wntrblm/Speak_to_Me/README.md

# Winterbloom Speak to Me

Speak to Me is a high quality headphone amplifier and low quality speaker monitor for Eurorack.

More details available at https://winterbloom.com/store/speak-to-me

## Repository layout

This repository contains the hardware design files and user guide for Speak to Me:

- **hardware/** contains the hardware design files for the mainboard, headphone jack breakout, and blank panel. These are all created using KiCAD.
- **user_guide/** contains the user's guide source files. These are written in Markdown and published using MkDocs.

## License and contributing

Speak to Me is open-source hardware and software, however, licensing a project like this is a little complicated. Please take a chance to review the [LICENSE](LICENSE.md) file.

We welcome contributions! Please read our [Code of Conduct](CODE_OF_CONDUCT.md) first.
