wntrblm/Speak_to_Me/hardware/headphone-breakout/3dmodels/CUI_DEVICES_SJ-63083D.step

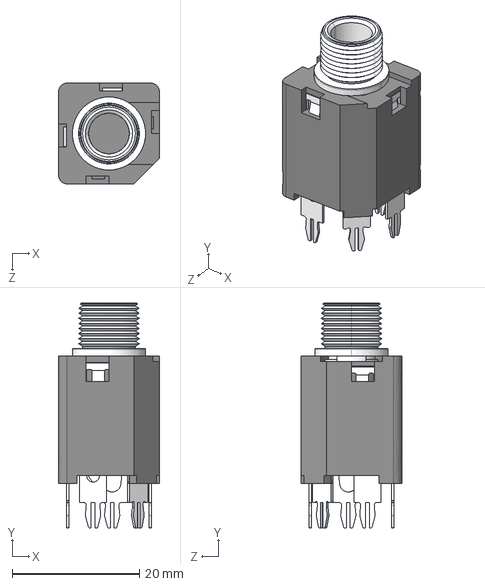
[picture p1: CAD file, 2021-05-23]
hardware/headphone-breakout/3dmodels/CUI_DEVICES_SJ-63083D.step
15.8 x 35.3 x 15.8 mm
