wntrblm/Speak_to_Me/hardware/board/3dmodels/AS04008PS-4W-WR-R.step

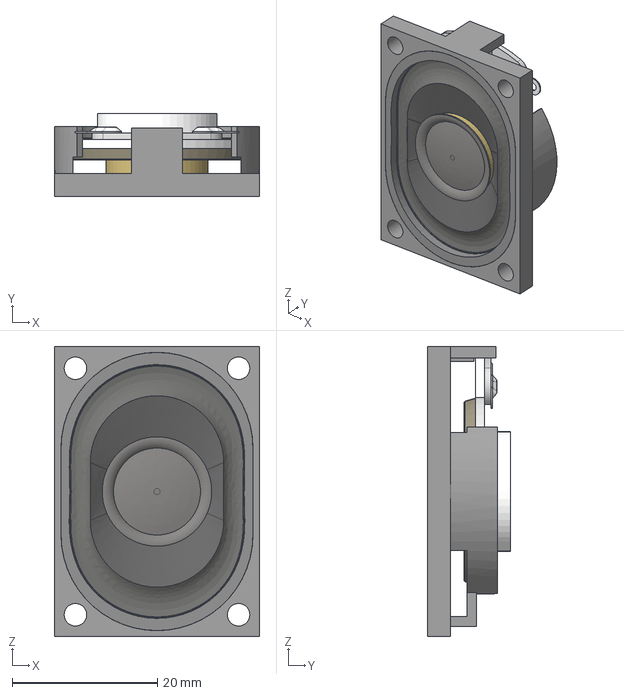
[picture p2: CAD file, 2021-05-23]
hardware/board/3dmodels/AS04008PS-4W-WR-R.step
28.3 x 11.5 x 40.0 mm
