wntrblm/Speak_to_Me/user_guide/docs/build.md

---
title: Kit build guide
---

# Build

Welcome to the build guide for Speak to Me's DIY kit. We hope you have a great time putting this module together and a wonderful time using it.

Please **read all instructions** thoroughly before starting. If you have questions or run into trouble please reach out to us on [discord] or drop us an email at support@winterbloom.com.

This kit is a beginner-level kit, but it does have a few tricky parts. If it's your first time soldering we recommend reading through [Adafruit's guide to excellent soldering](https://learn.adafruit.com/adafruit-guide-excellent-soldering) and practicing a little before jumping in.

This build takes around **two hours** to complete.

[discord]: https://discord.gg/UpfqghQ

## Tools required

Before you begin, make sure that you've got:

-   Safety glasses. Yes, **really**. A pair like [these][safety glasses] are fine.
-   Proper ventilation, like this [small filtered fan](https://a.co/d/eUfPCRO).
-   A **temperature-controlled** soldering iron, like this [Hakko] or the [Pinecil]. It is very important to use a temperature-controlled iron, since unregulated irons can easily get hot enough to damage components. You should set your iron temperature based on your solder manufacturer's recommendations.
-   Solder. We recommend [Adafruit's SAC305 solder][adafruit solder] or [Kester 275 K100LD].

!!! question "Flux"
    We suggest using solder with "no clean" flux. If you use a different kind of flux, be sure to carefully clean the flux residue off based on the guidelines provided by the manufacturer of your solder. Take special care with the LEDs and potentiometers, as they can be damaged by water and flux cleaners.

[safety glasses]: https://a.co/d/dMXvPP6
[tweezers]: https://www.adafruit.com/product/422
[Hakko]: https://www.adafruit.com/product/1204
[Pinecil]: https://pine64.com/product/pinecil-smart-mini-portable-soldering-iron/
[adafruit solder]: https://www.adafruit.com/product/734
[Kester 275 K100LD]: https://www.kester.com/products/product/275-flux-cored-wire
[flux pen]: https://www.sra-solder.com/sra-312-no-clean-flux-pen-refillable

## Kit contents

Your kit should contain the following items. If any are missing please email us at support@winterbloom.com.

<winter-image-map src="../images/kit.svg">
    <winter-image-map-item id="mainboard">Mainboard</winter-image-map-item>
    <winter-image-map-item id="panel">Front panel</winter-image-map-item>
    <winter-image-map-item id="jacks">1/8" jacks (2)</winter-image-map-item>
    <winter-image-map-item id="jack-nuts">Hex nuts for the 1/8" jacks (2)</winter-image-map-item>
    <winter-image-map-item id="power-header">Eurorack power header</winter-image-map-item>
    <winter-image-map-item id="rubber-band">Rubber band</winter-image-map-item>
    <winter-image-map-item id="jst-cable">JST wiring harness</winter-image-map-item>
    <winter-image-map-item id="_2p5-l-wrench">2.5mm L wrench</winter-image-map-item>
    <winter-image-map-item id="_2-l-wrench">2mm L wrench</winter-image-map-item>
    <winter-image-map-item id="m3-bolts">M3x12 black hex bolts (4)</winter-image-map-item>
    <winter-image-map-item id="m3-nuts">M3 nuts (4)</winter-image-map-item>
    <winter-image-map-item id="jst-header">JST XH-2 header</winter-image-map-item>
    <winter-image-map-item id="pot">Stereo potentiometer</winter-image-map-item>
    <winter-image-map-item id="ffc">Flat flex cable</winter-image-map-item>
    <winter-image-map-item id="speaker">Speaker</winter-image-map-item>
    <winter-image-map-item id="grill">Grille cloth</winter-image-map-item>
    <winter-image-map-item id="big-jack">1/4 stereo jack</winter-image-map-item>
    <winter-image-map-item id="spacer">Speaker spacer</winter-image-map-item>
    <winter-image-map-item id="knob">Knob</winter-image-map-item>
    <winter-image-map-item id="headphone-breakout">Headphone jack breakout board</winter-image-map-item>
</winter-image-map>

- (1) Mainboard
- (1) Front panel
- (1) Headphone jack breakout board
- (1) Stereo potentiometer, including nut & washer
- (1) Speaker
- (1) 20mm aluminum knob
- (4) M3x12 black hex bolts
- (4) M3 nuts
- (1) Grille cloth
- (1) Speaker spacer
- (1) 2mm L wrench
- (1) 2.5mm L wrench
- (1) 5-position flat flex cable
- (2) 1/8" jacks, including nuts
- (1) 1/4" stereo jack, including nut
- (1) JST XH-2 header
- (1) JST 2-pin wiring harness
- (1) Eurorack power header
- (1) Rubber band

## Soldering the power header

Your first task is to place and solder the power header and JST header to the mainboard.

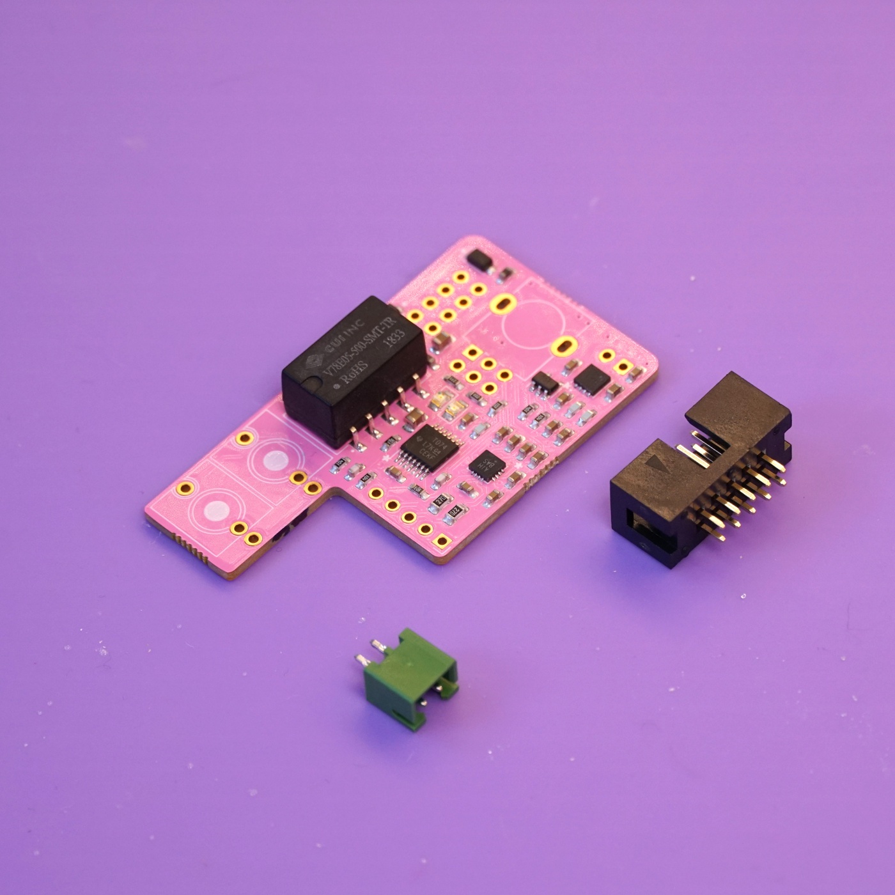
[picture p3: user_guide/docs/images/2-mb-3.jpg]
The mainboard, power header, and JST header


Start by placing the power header onto the back side of the mainboard, being careful to align the notch in the header with the drawing on the board. The power header fits snugly, so you might have to give it a little pressure to push it all the way in.

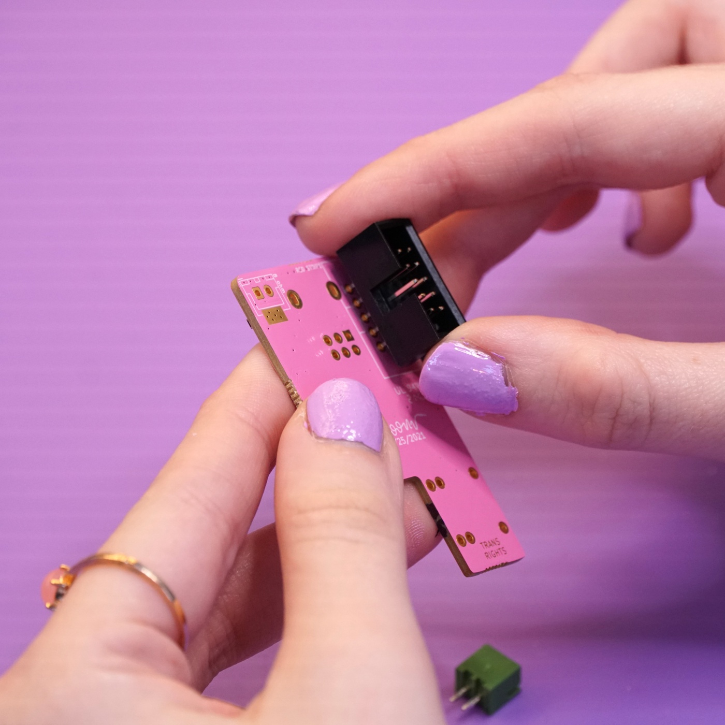
[picture p4: user_guide/docs/images/3-pw-5.jpg]
The power header being placed on to the back side of the motherboard


Flip the board over to the front side and solder the header's 10 pins. Take care not to damage any of the nearby components.

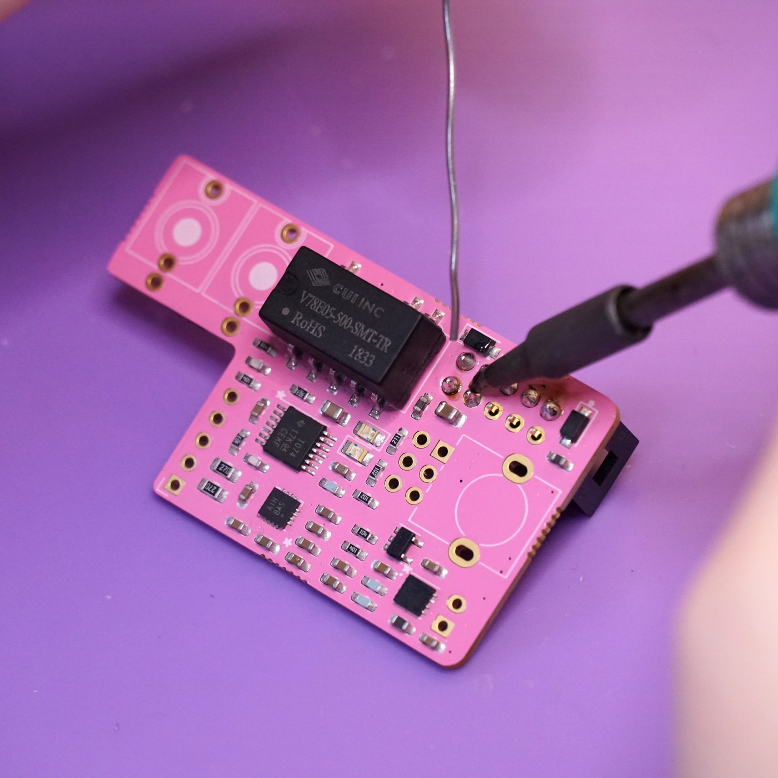
[picture p5: user_guide/docs/images/4-pws-8.jpg]
The power header's pins being soldered in place


Next, place the JST header on the back side of the board. Just like with the power header, align the header with the drawing on the board. The header should not hang over the edge of the board.

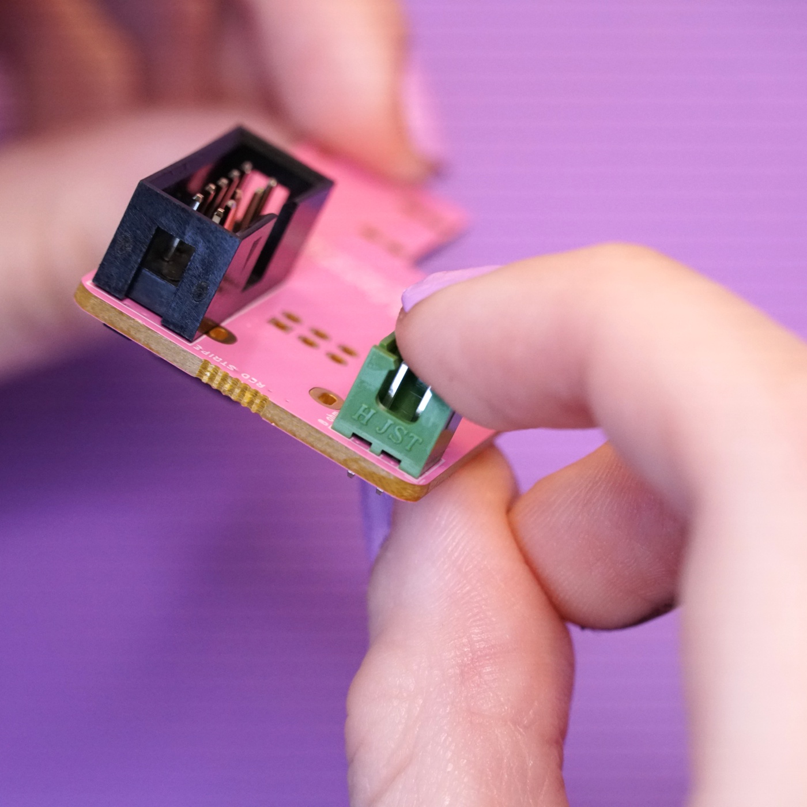
[picture p6: user_guide/docs/images/5-jst-4.jpg]
The JST header placed on the back side of the board


Flip the board over and solder the JST header's two pins.

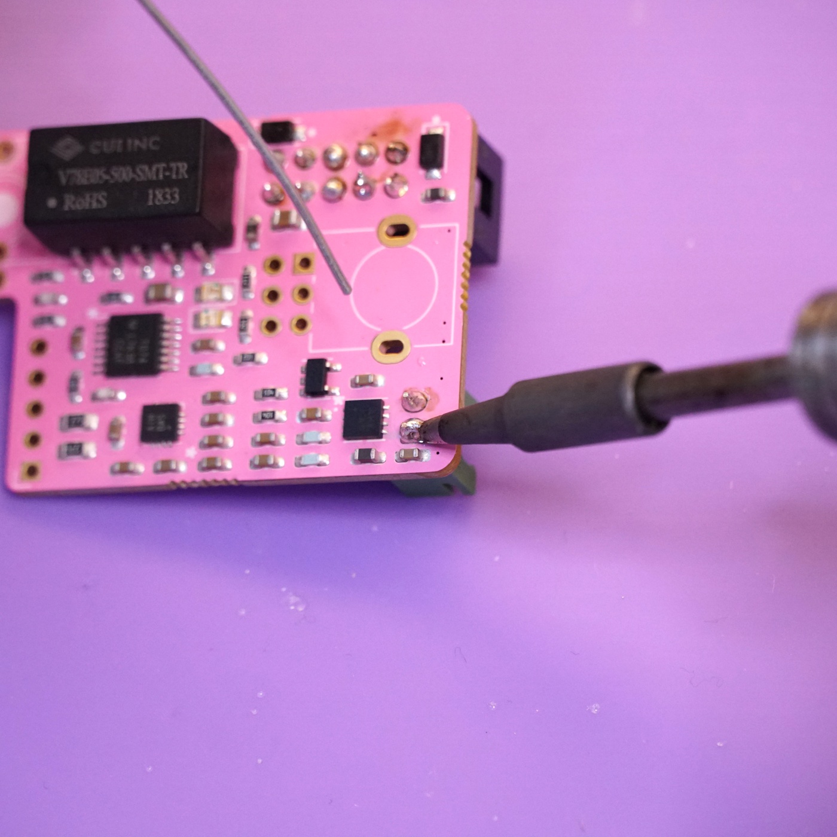
[picture p7: user_guide/docs/images/6-jsts-3.jpg]
The JST header's pin being soldered in place


## Placing the front side components

Next up is placing the components on the front side of the mainboard. You'll need the 1/8" jacks, the stereo potentiometer, the front panel, and the rubber band for this section.

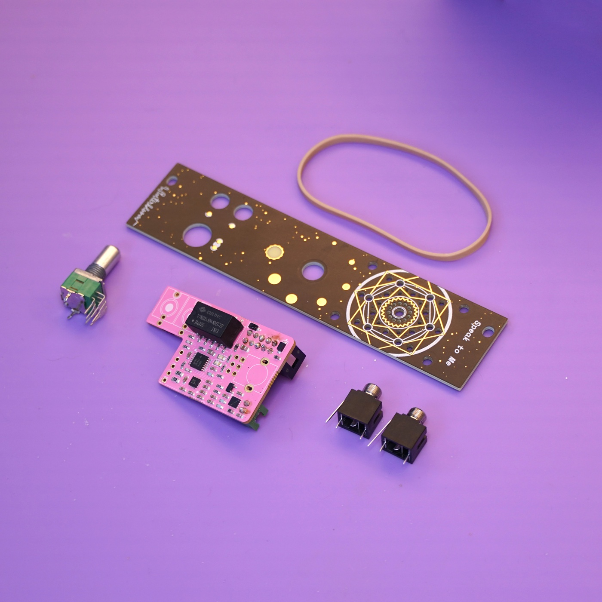
[picture p8: user_guide/docs/images/7-jacks-and-pot-4.jpg]
The panel, mainboard, 1/8" jacks, stereo potentiometer, and a rubber band


Start by placing the potentiometer on the front side of the board. You might need to slightly straighten out the legs of the potentiometer to get it to go in - don't use excessive force to push it in. Remove the nut and washer on the potentiometer and set it aside for now.

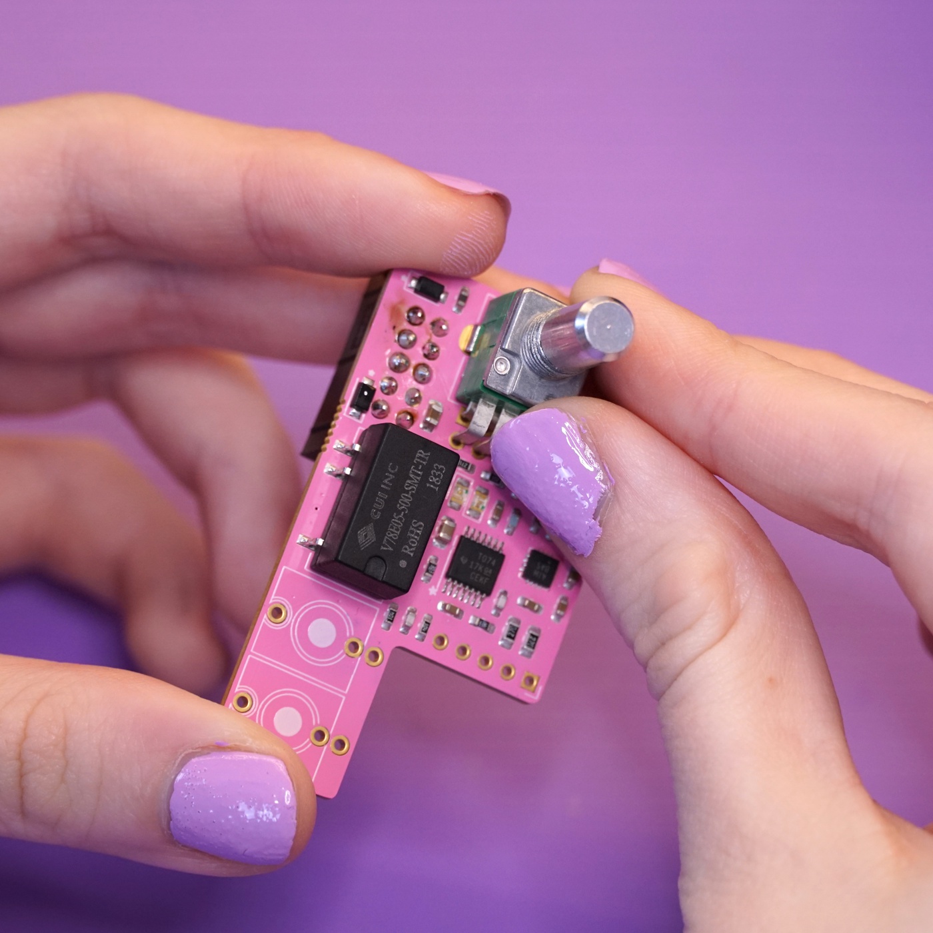
[picture p9: user_guide/docs/images/8-pot-3.jpg]
The potentiometer placed on the front side of the board


Continue by placing the two 1/8" jacks on the front side of the board. Be sure to get the little flexible third leg into its hole.

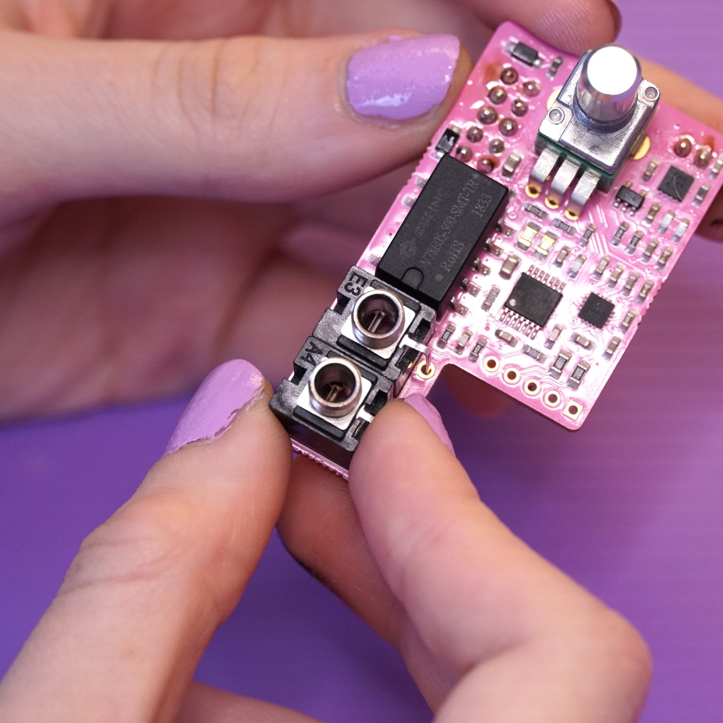
[picture p10: user_guide/docs/images/9-jacks-2.jpg]
The two 1/8" jacks placed on the front side of the board


## Using the front panel as a jig

Since the potentiometer and jacks need to peek through the front panel, you can use it as a jig to make sure everything stays in the right place while soldering. Carefully line up the front panel's holes with the potentiometer and jack and push the front panel on.

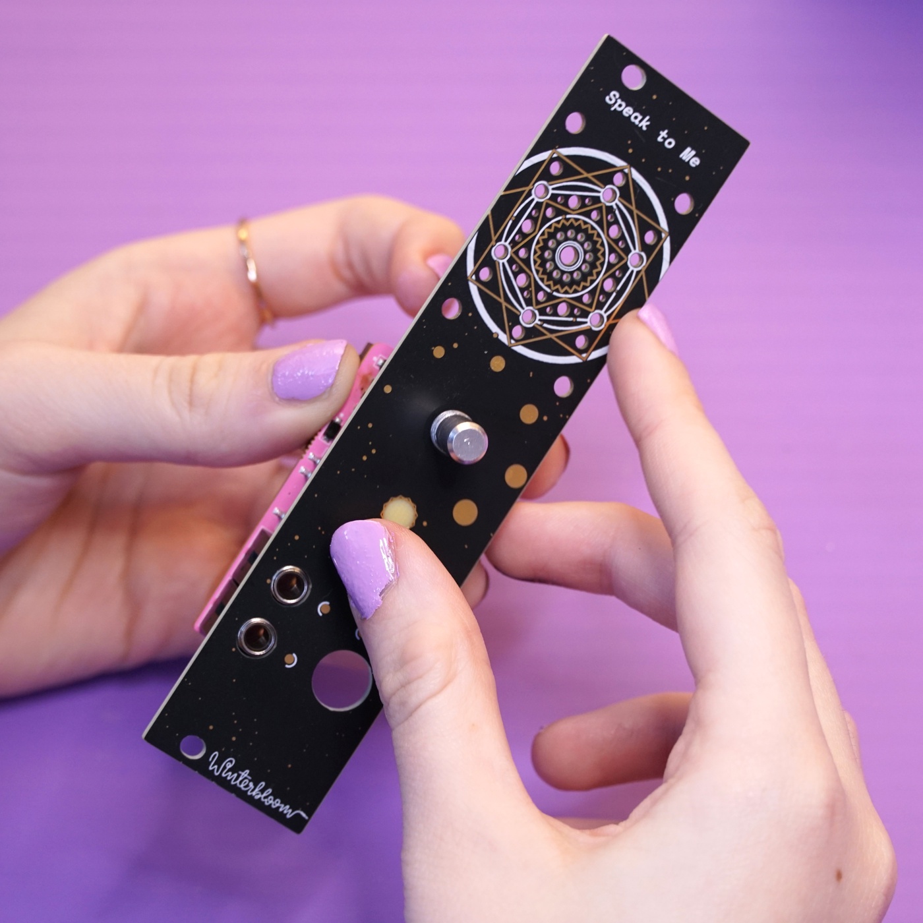
[picture p11: user_guide/docs/images/10-panel-1.jpg]
The panel being placed over the mainboard's jacks and potentiometer


Use the rubber band to temporarily hold the front panel on while you're working on it. You'll need to double- or triple- over the rubber band to get it tight.

<winter-carousel>
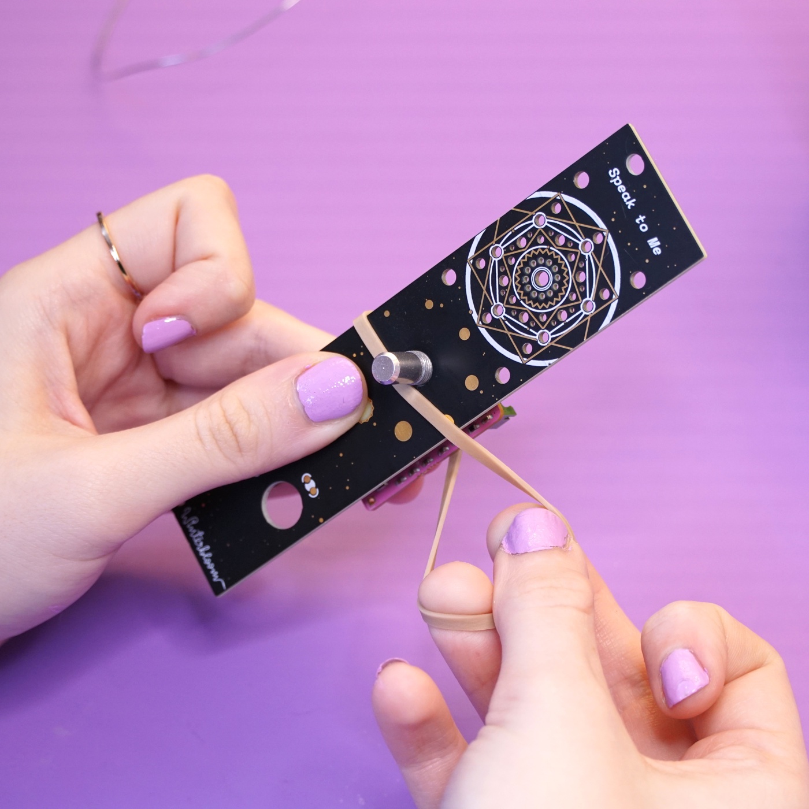
[picture p12: user_guide/docs/images/11-rubber-band-4.jpg]
A rubber band being pulled taught across the center of the module
    
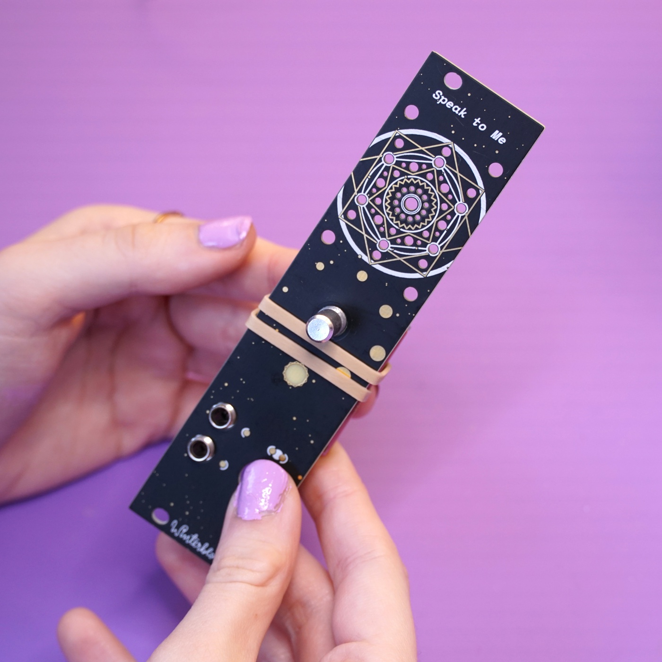
[picture p13: user_guide/docs/images/11-rubber-band-3.jpg]
The module with a doubled-overed rubber band holding the panel in place
    
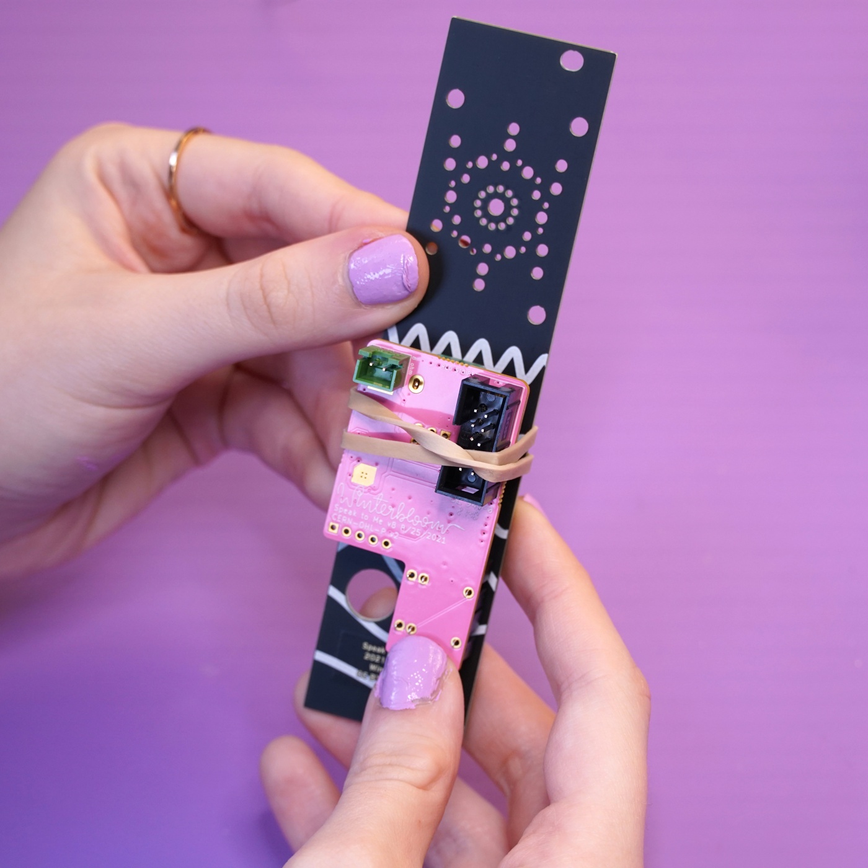
[picture p14: user_guide/docs/images/11-rubber-band-2.jpg]
The same but showing the back side of the module
    
</winter-carousel>

## Soldering the front side components

With everything held in place, you can now flip the module over and solder all of the front panel components in place. As you go, take a moment now and then to check that everything is flush with the panel and mainboard.

Start by soldering the two 1/8" jacks.

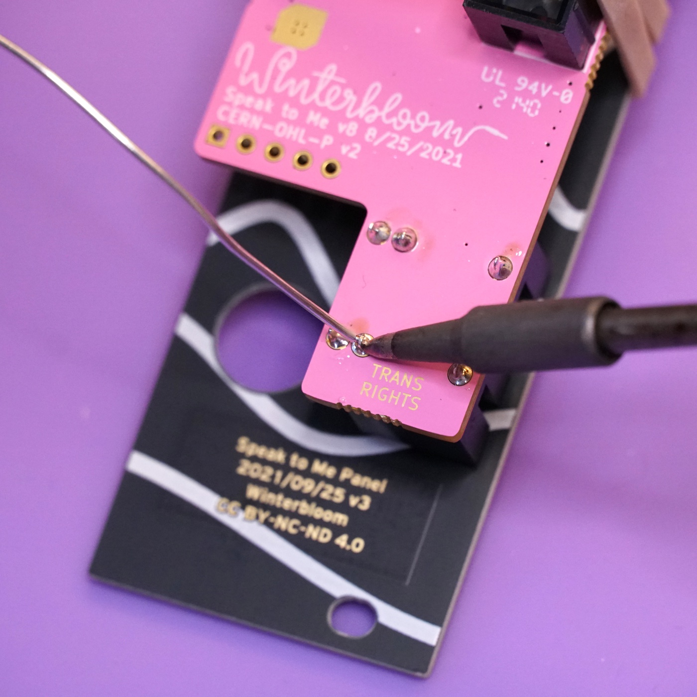
[picture p15: user_guide/docs/images/12-soldering-jacks-2.jpg]
The pins on the 1/8" jacks being soldered in place


Next up is the potentiometer. This one can be a little tricky so read through all of these instructions and use caution. First, move the rubber band slightly to get a clear look at the potentiometer's holes.

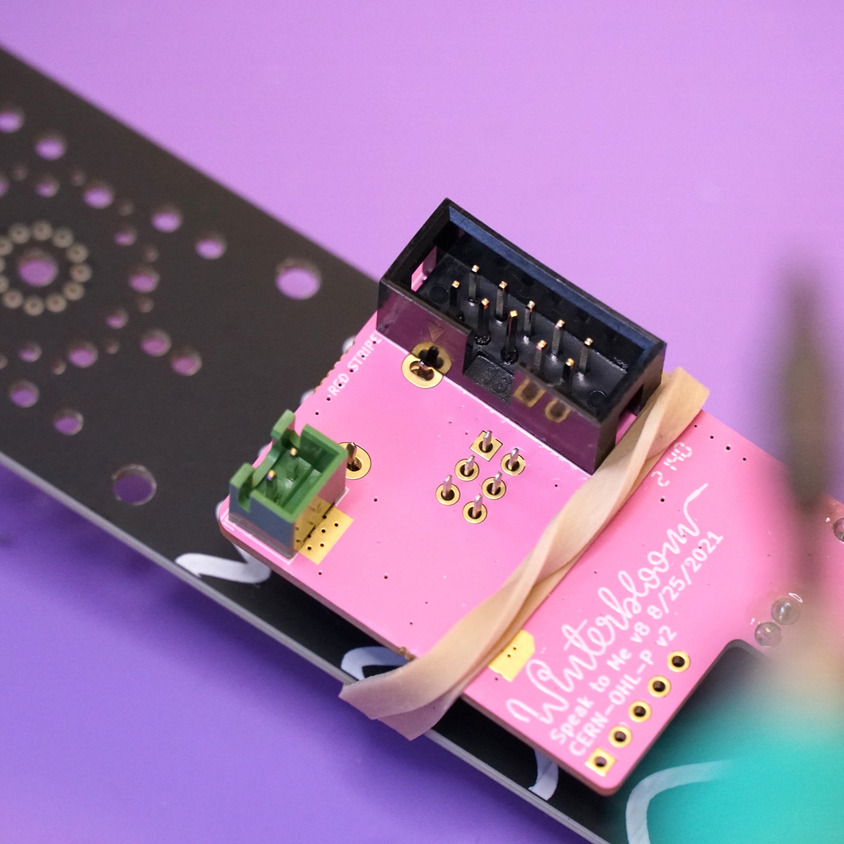
[picture p16: user_guide/docs/images/13-soldering-pot-9.jpg]
The back side of the board, showing the rubber band moved down slightly to reveal the pins and legs for the potentiometer


Next, solder the two *large* legs of the potentiometer one at a time. When soldering the one next to the power header, be careful not to melt the power header with your iron. After soldering the first one, double-check that the potentiometer is flush with the mainboard and adjust if needed.

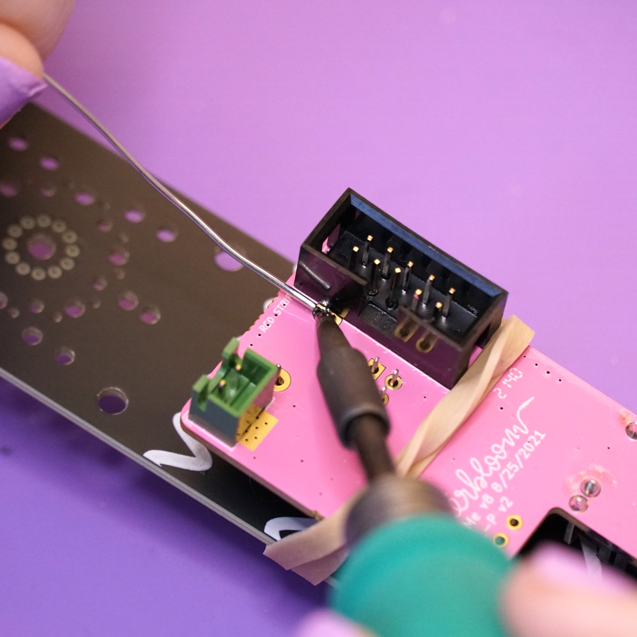
[picture p17: user_guide/docs/images/13-soldering-pot-2.jpg]
The potentiometer's leg being soldered in place


With the two legs soldered, finish up by soldering the six remaining pins.

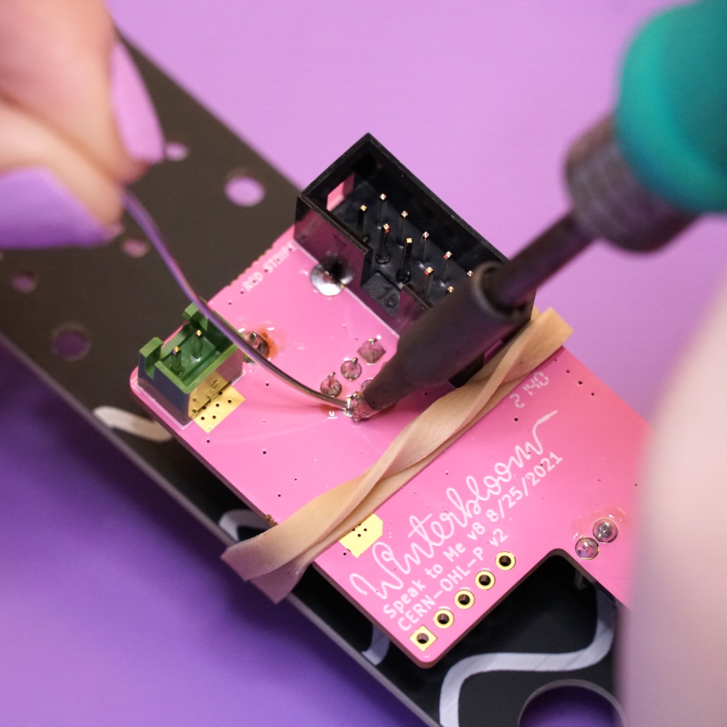
[picture p18: user_guide/docs/images/14-soldering-pot-pt-2-2.jpg]
The potentiometer's 6 pins being soldered


## Soldering the flat flex cable to the mainboard

Next up is soldering the flat flex cable to the mainboard.

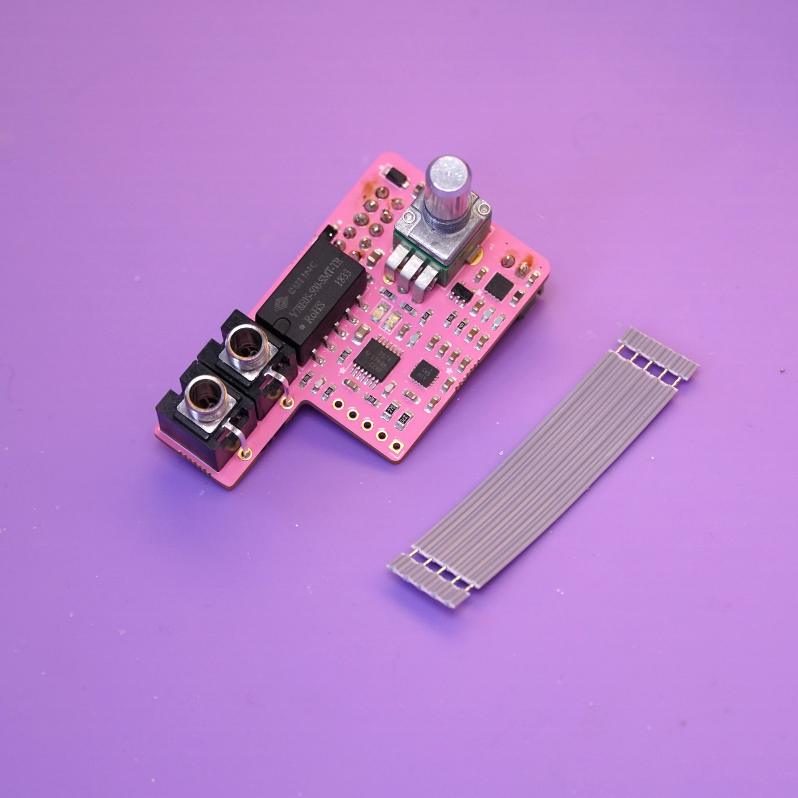
[picture p19: user_guide/docs/images/15-ffc-1.jpg]
The mainboard and the flat flex cable


Prepare the flat flex cable by removing the cover on one side of it. Just pull up lightly to get the cover to come off- **do not cut the flat flex cable**.

<winter-carousel>
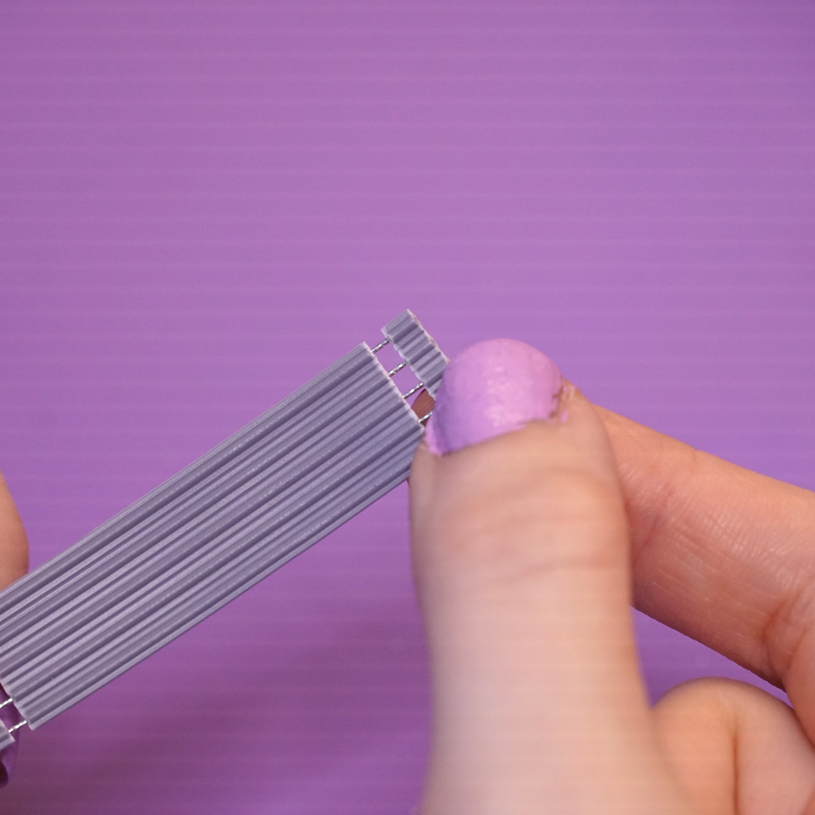
[picture p20: user_guide/docs/images/16-ffc-prep-3.jpg]
The flat flex cable with the small cover on the top of it being held lightly
    
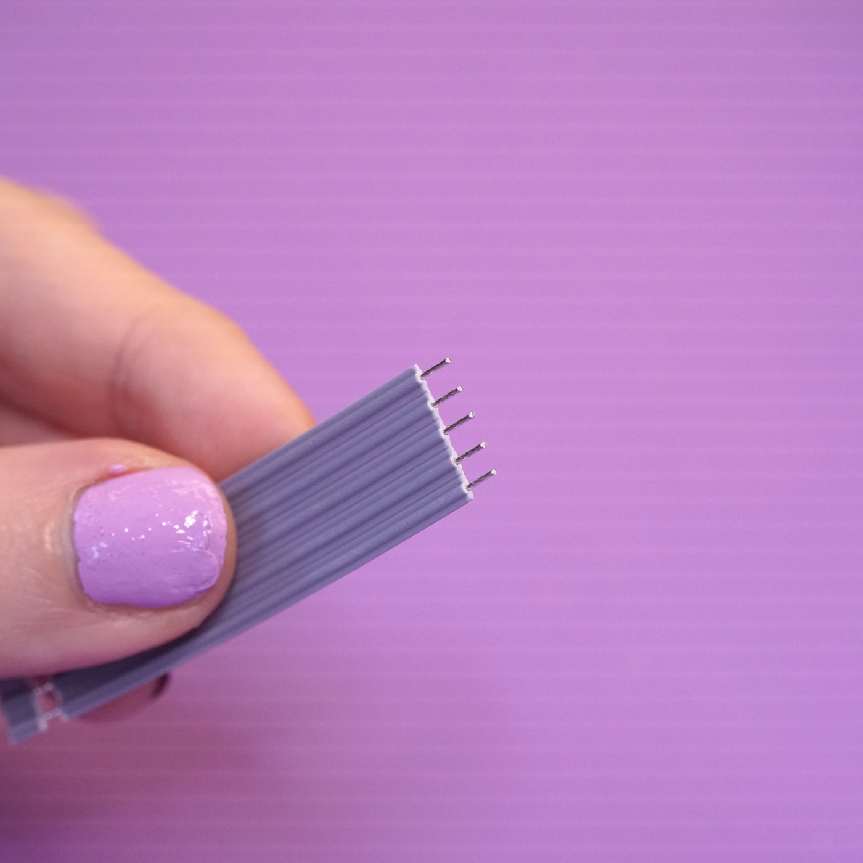
[picture p21: user_guide/docs/images/16-ffc-prep-1.jpg]
The flat flex cable with the small cover on the top removed, revealing the conductors
    
</winter-carousel>

Push the exposed conductors of the flat flex cable through the matching holes on the motherboard. This is designed to go together easily, just be take care not to bend any of the conductors.

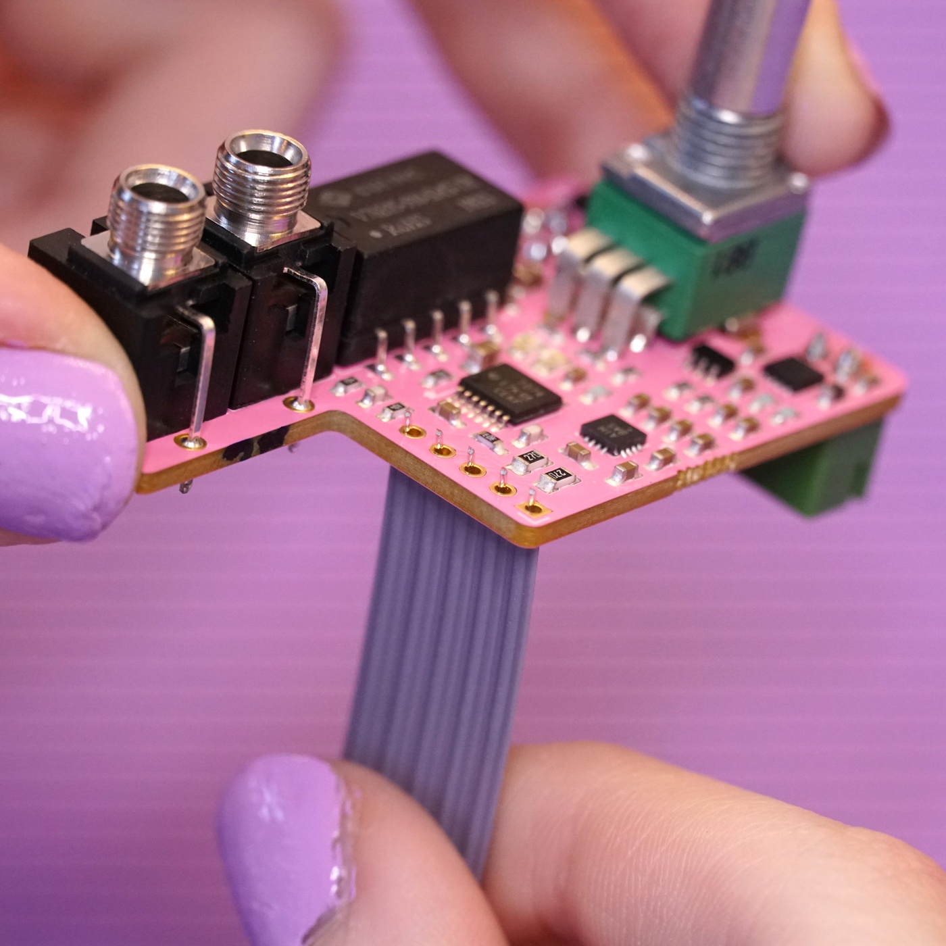
[picture p22: user_guide/docs/images/17-ffc-connect-3.jpg]
The flat flex cable placed through the five holes on the mainboard through the back side


With everything in place, solder the five flat flex cable conductors to the motherboard.

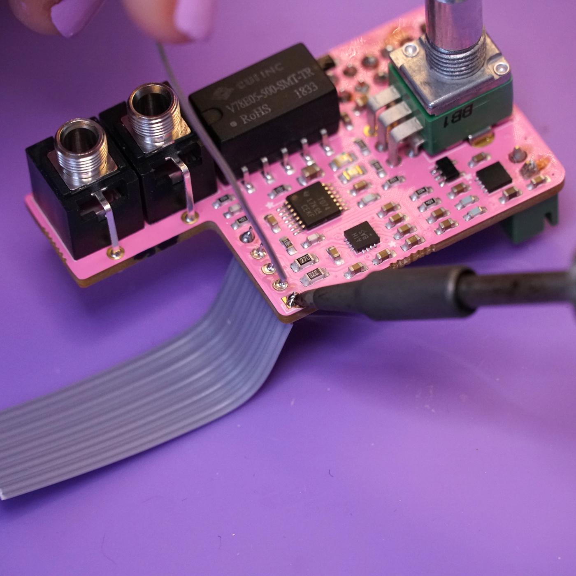
[picture p23: user_guide/docs/images/18-solder-ffc-1.jpg]
The flat flex cable's five conductors soldered onto the mainboard


## Soldering the flat flex cable to the headphone breakout

With one side of the flat flex cable done, the next step is to connect the other side to the headphone breakout board.

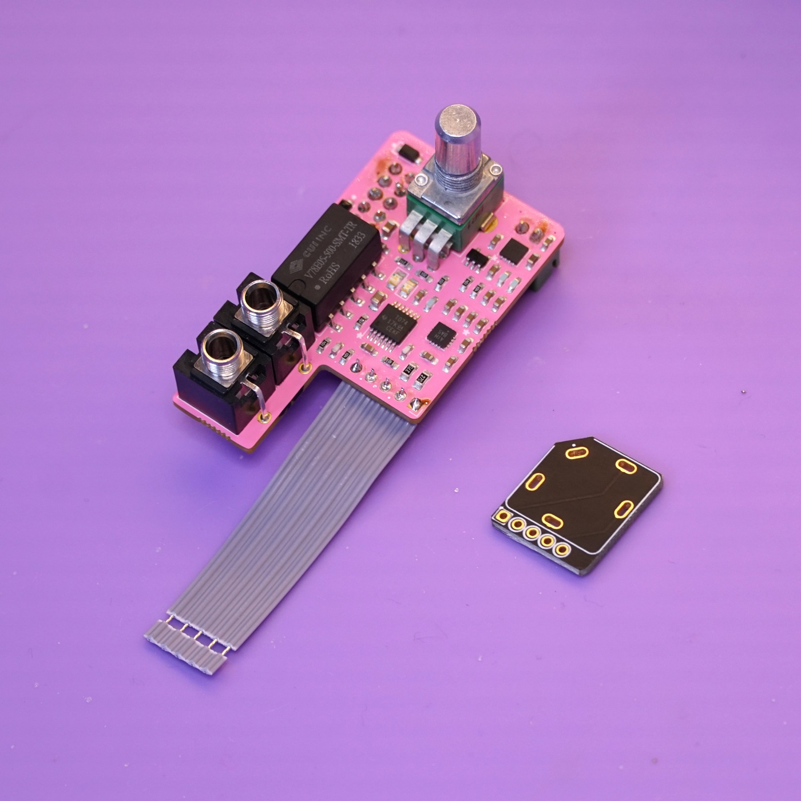
[picture p24: user_guide/docs/images/19-ffc-and-hp-breakout-5.jpg]
The mainboard (with the flat flex cable attached) and the headphone breakout board


Just like in the previous step, remove the cover for the flat flex cable. Push it through the matching holes on the headphone breakout board. Note the orientation of the breakout board relative to the mainboard. The side **without any text** is the front side and should be facing the same direction as the front side of the mainboard.

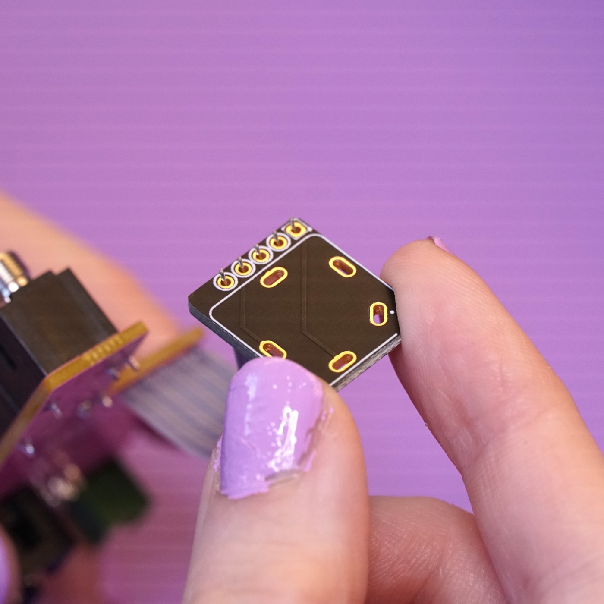
[picture p25: user_guide/docs/images/20-ffc-hp-1.jpg]
The five conductors of the flat flex cable pushed through the five holes on the headphone breakout board


Double check the orientation and then solder the flat flex cable in place.

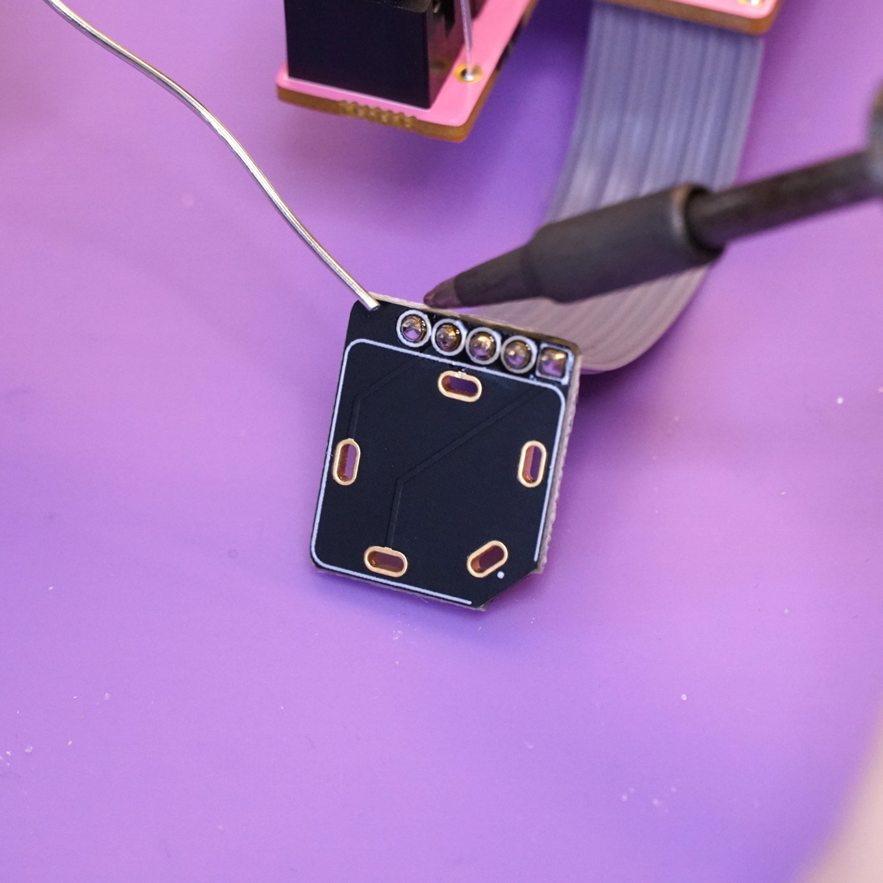
[picture p26: user_guide/docs/images/21-ffc-soldering4.jpg]
The five conductors of the flat flex cable soldered to the headphone breakout board


## Soldering the 1/4" jack

Next up is soldering the large 1/4" jack to the jack breakout board. Before starting, remove the nut and washer from the jack and set aside.

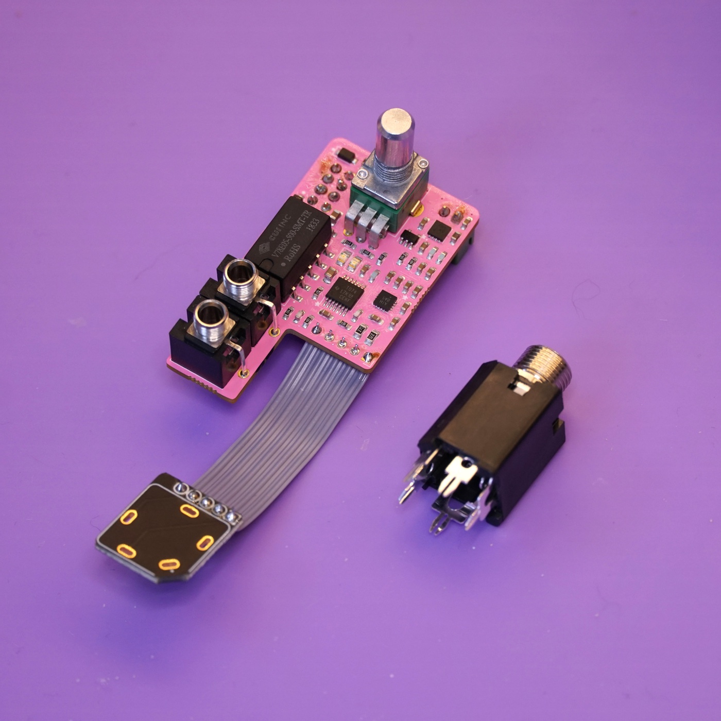
[picture p27: user_guide/docs/images/22-big-jack-4.jpg]
The mainboard assembly with flat flex cable and headphone breakout attached along with the large 1/4" jack


Place the jack on the front side of the breakout board. The jack has one slanted side so that it can only go in one way. The jack's legs will not go all the way through the board so don't use excessive force to place it.

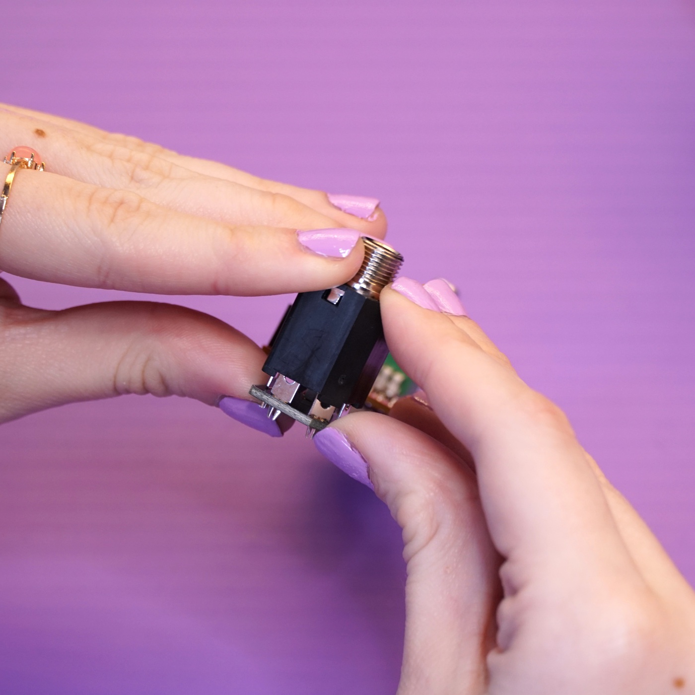
[picture p28: user_guide/docs/images/23-big-jack-placement-4.jpg]
The large 1/4" jack placed on to the front side of the headphone breakout board


Solder the legs of the jack and take care not to melt the flat flex cable.

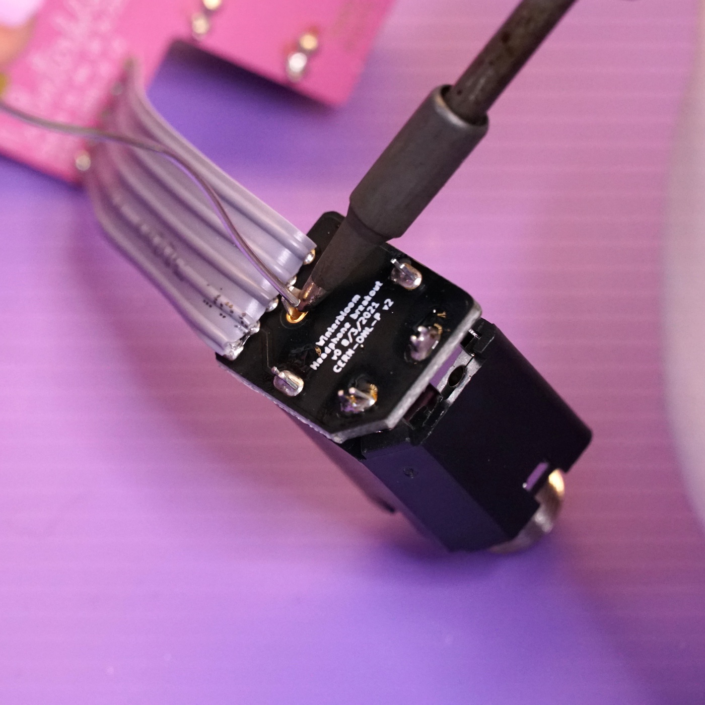
[picture p29: user_guide/docs/images/24-big-jack-soldering-5.jpg]
The back side of the headphone breakout board with the 1/4"'s legs being soldered in place


## Preparing the speaker

With the mainboard complete, your next task is to prepare the speaker. You'll need the speaker and the JST wiring harness.

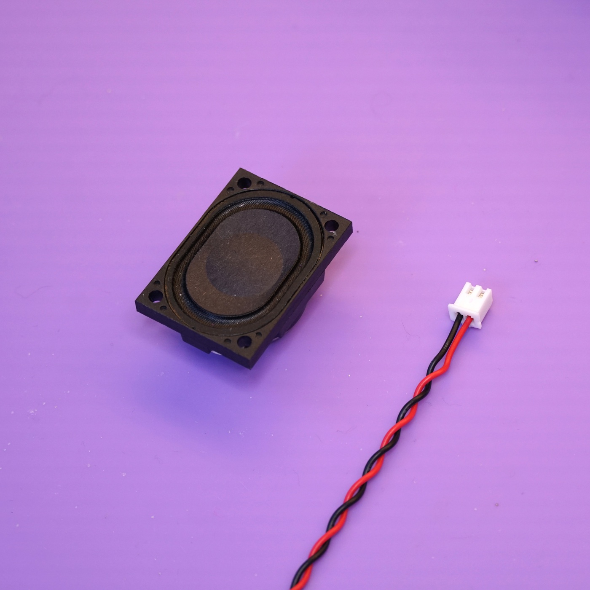
[picture p30: user_guide/docs/images/25-speaker-and-jst-4.jpg]
The speaker and the JST wiring harness


Un-twist the end of the leads a little and solder the leads to the eyelets on the speaker. For Speak to Me, polarity does not matter, however, if you like to be thorough and proper the speaker's eyelets are marked with "+" and "-". Solder the black lead to the "-" eyelet and the red lead to the "+" eyelet.

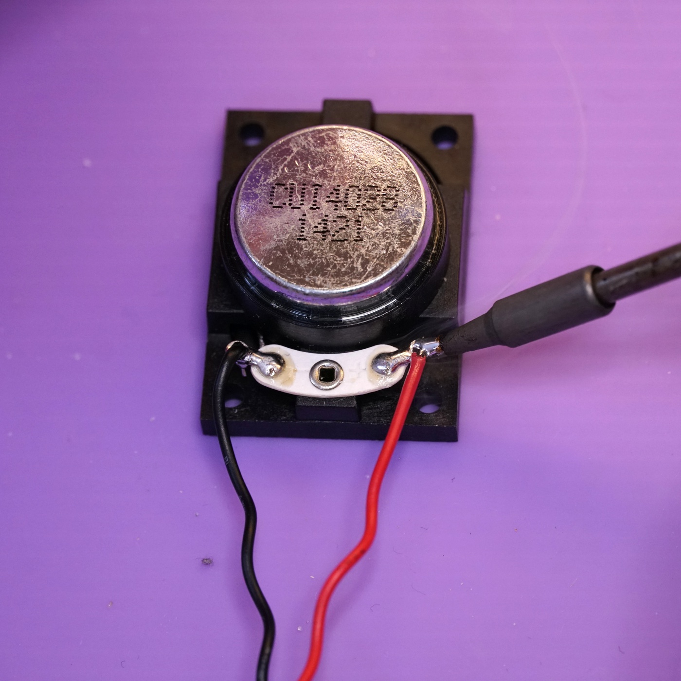
[picture p31: user_guide/docs/images/27-speaker-soldering-1.jpg]
The leads of the JST wiring harness being soldered to the speaker


At this point you are done soldering! You can put your iron away if you'd like.

## Mounting the speaker

Now that the speaker has its cable, your next task is to mount it to the front panel. You'll need the speaker, panel, grill cloth, speaker spacer, the four M3 bolts and nuts, and the 2.5mm L wrench.

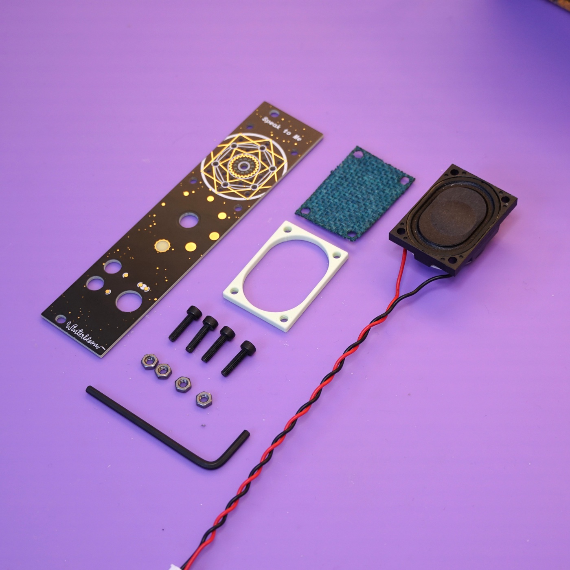
[picture p32: user_guide/docs/images/28-speaker-hardware-2.jpg]
The panel, speaker, grill cloth, speaker spacer, M3 bolts, M3 nuts, and a 2.5mm L wrench


Start by pushing two of the bolts through the mounting holes on the front side of the panel and then placing the panel face-down with the bolts sticking up. Put the bolts on opposite corners - one at the bottom-right and one at the top-left.

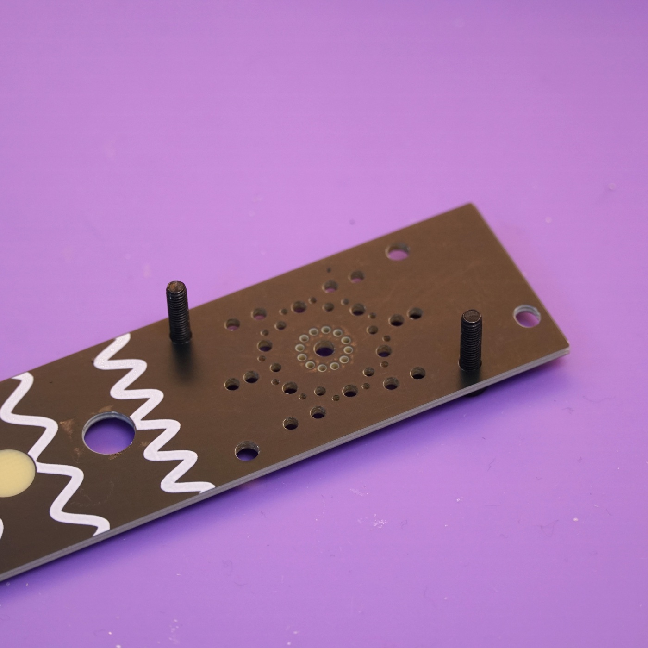
[picture p33: user_guide/docs/images/29-bolts-1.jpg]
The panel with two bolts placed through it, lying face down with the bolts sticking up


Next, place the grill cloth through the bolts and flush up against the panel.

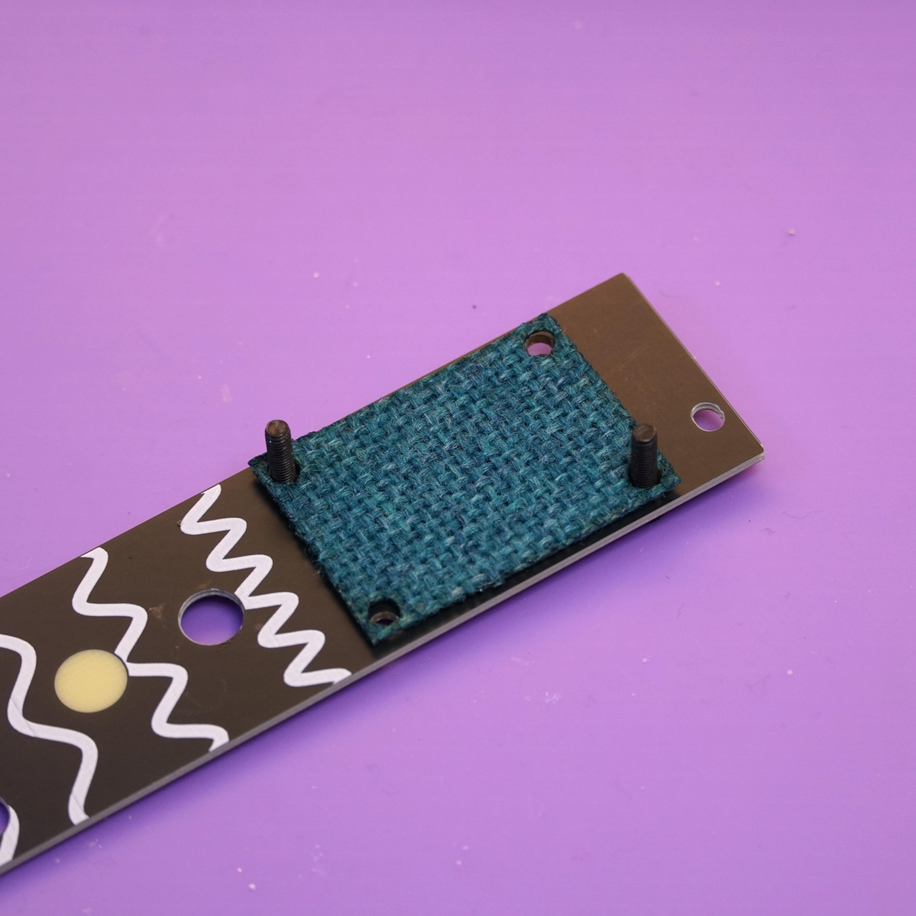
[picture p34: user_guide/docs/images/30-grill-2.jpg]
The same picture, but with the grill cloth placed on the bolts and flush against the panel


Now place the speaker spacer through the bolts and flush against the grill cloth.

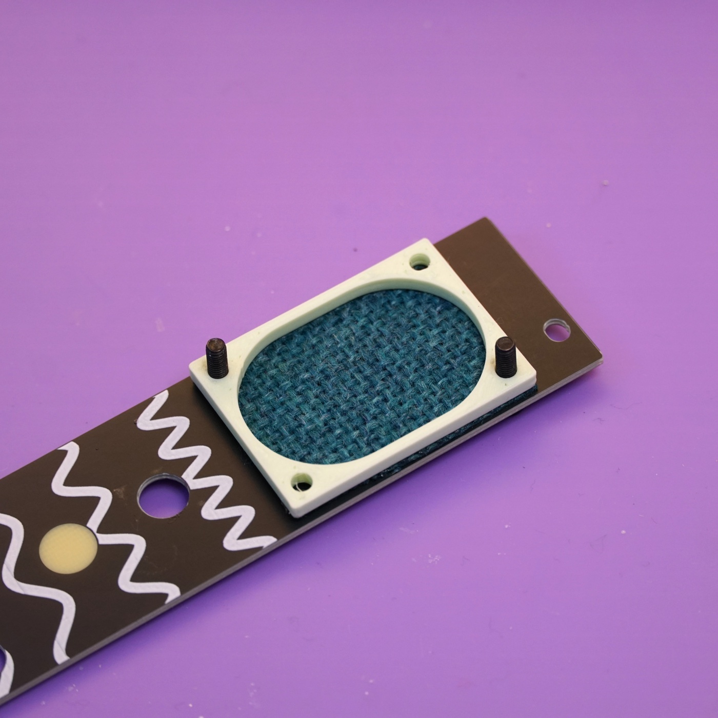
[picture p35: user_guide/docs/images/31-spacer-1.jpg]
The same picture, but now with the speaker spacer placed on the bolts and flush against the panel


Then place the speaker through the bolts and flush against the spacer. The bolts might be a bit tight here, if needed, flip the assembly over and use the 2.5mm L wrench to screw the bolts through.

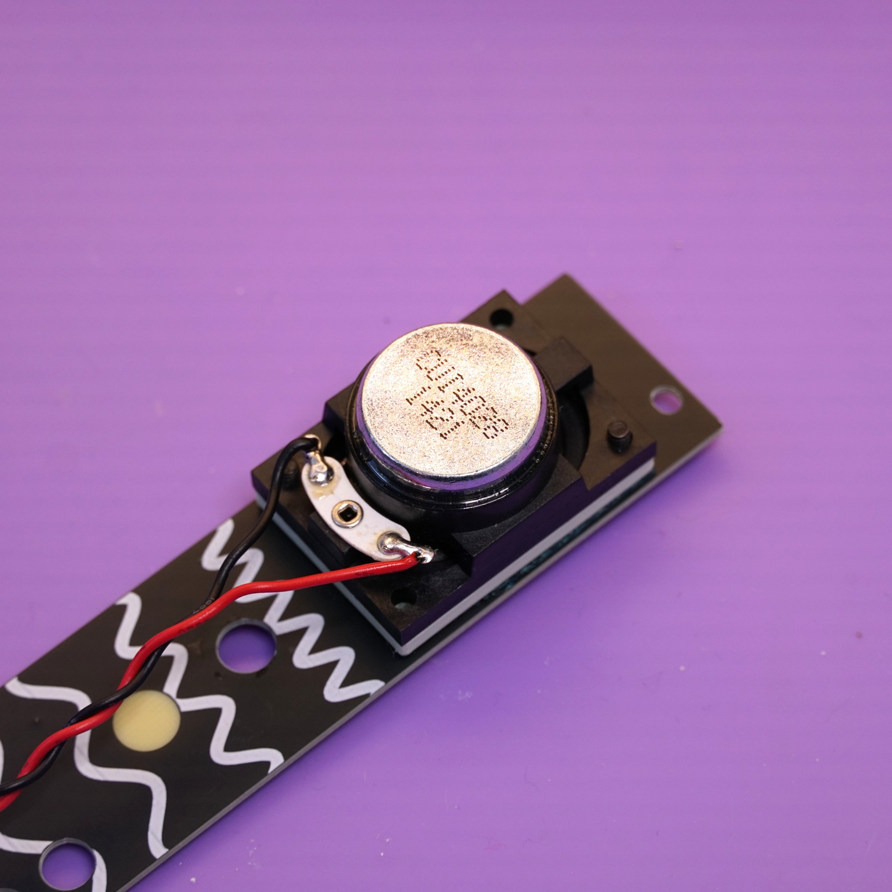
[picture p36: user_guide/docs/images/32-mount-speaker-2.jpg]
The same picture, but now with the speaker placed on the boards and flush against the spacer


Take one of the M3 nuts and attach it to the bolt on the top of the speaker. Don't fully tighten it yet.

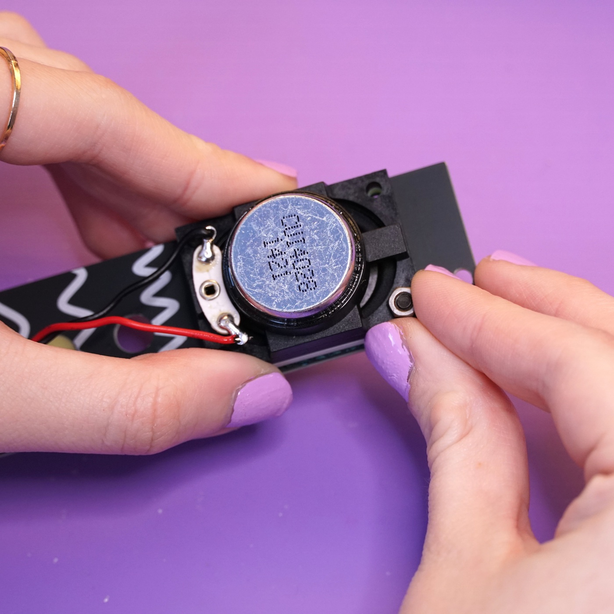
[picture p37: user_guide/docs/images/33-first-nut-3.jpg]
The speaker assembly with an M3 nut being hand-tightened onto one of the bolts


Do the same with the bolt on the bottom of the speaker. The speaker's eyelet might be in the way a little, you can bend it **very slightly** up to give yourself a bit more space. You can use the 2.5mm L wrench to back the bolt out a bit if needed.

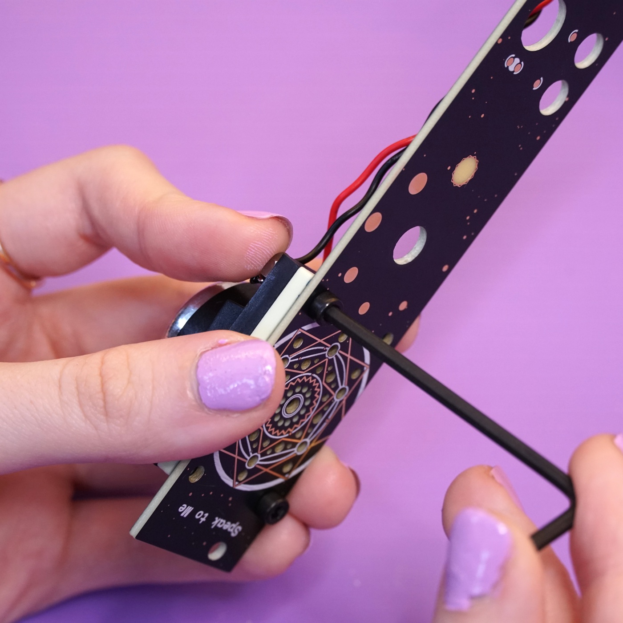
[picture p38: user_guide/docs/images/34-tighten-nut-2.jpg]
The assembly with another M3 nut being placed while turning the bolt with the 2.5mm L wrench


Add the remaining two bolts and nuts. These bolts will have a lot more resistance than the first two and you'll need to use the 2.5 L wrench to screw them through the grill cloth, speaker spacer, and speaker to reach the bolt.

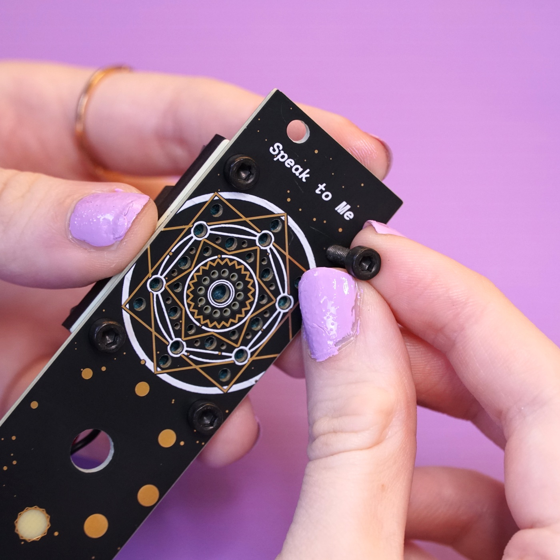
[picture p39: user_guide/docs/images/35-other-bolts-4.jpg]
The front of the assembly with a third bolt being placed through one of the corners


Finally, tighten all the bolts carefully with the 2.5mm L wrench. They should be snug but do not over-tighten then as you could crack the speaker spacer.

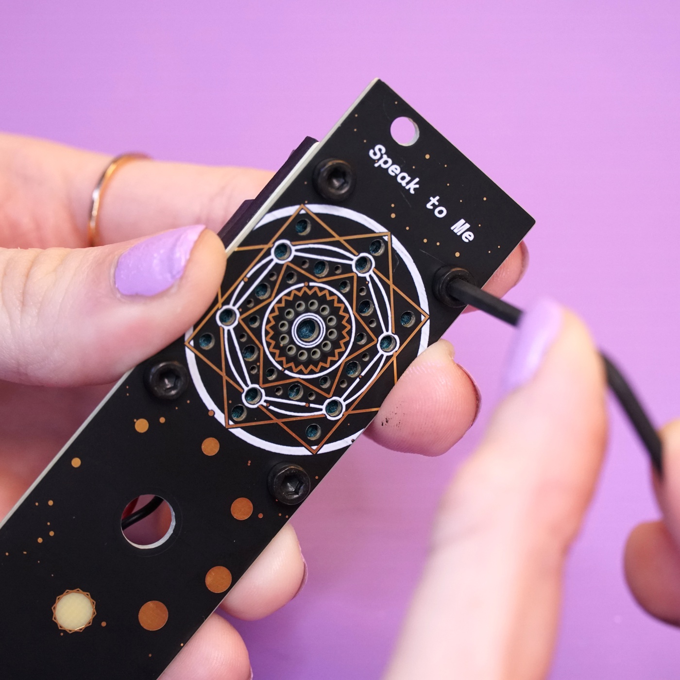
[picture p40: user_guide/docs/images/36-tighten-all-bolts-3.jpg]
The front of the assembly with one of the bolts being tightening with the 2.5mm L wrench


## Mounting mainboard to the panel

With the speaker mounted to the panel, it's time to mount the mainboard. You'll need the panel assembly, the mainboard, the nuts for the 1/8" jack, the jack and washer for the potentiometer, and the jack and washer for the 1/4" jack.

Place the panel over the 1/8" jacks and the potentiometer - the same way you did when using the panel to align components before soldering them.

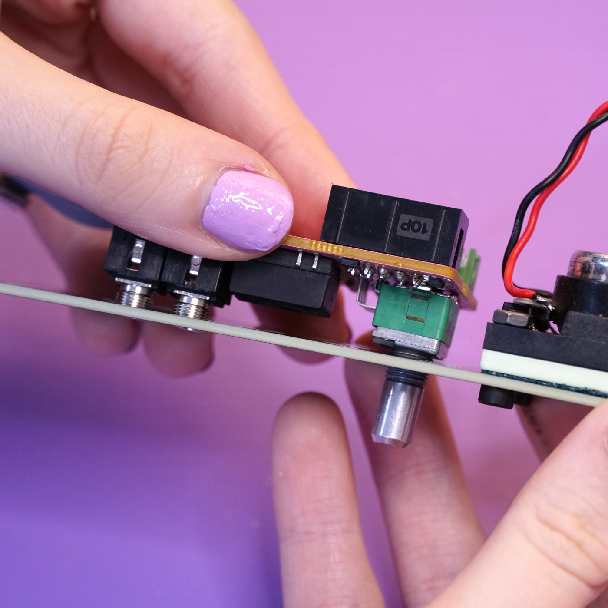
[picture p41: user_guide/docs/images/37-mount-panel-2.jpg]
The main board pushed flush against the back of the panel


Use the potentiometer's washer and nut to secure it to the panel.

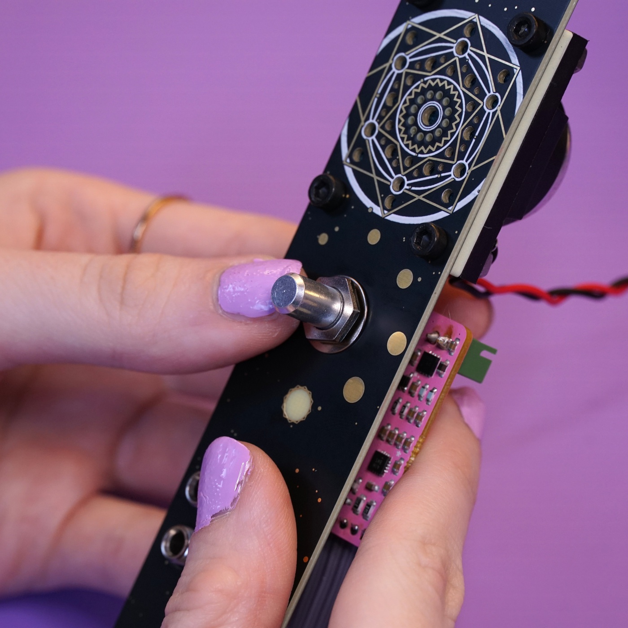
[picture p42: user_guide/docs/images/38-mount-pot-1.jpg]
The potentiometer's nut being tightened by hand


Secure the two 1/8" with their nuts.

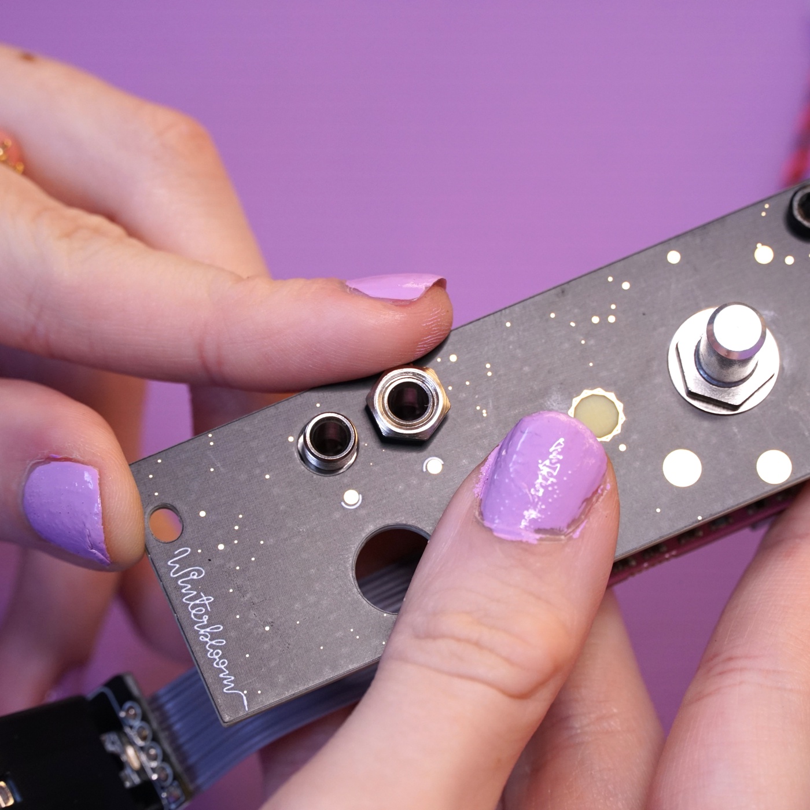
[picture p43: user_guide/docs/images/39-mount-jacks-3.jpg]
The two 1/8" jack nuts being placed and tightened by hand


Push the large 1/4" jack through its hole in the panel. The flat flex cable will need to bend a bit to get it all to line up.

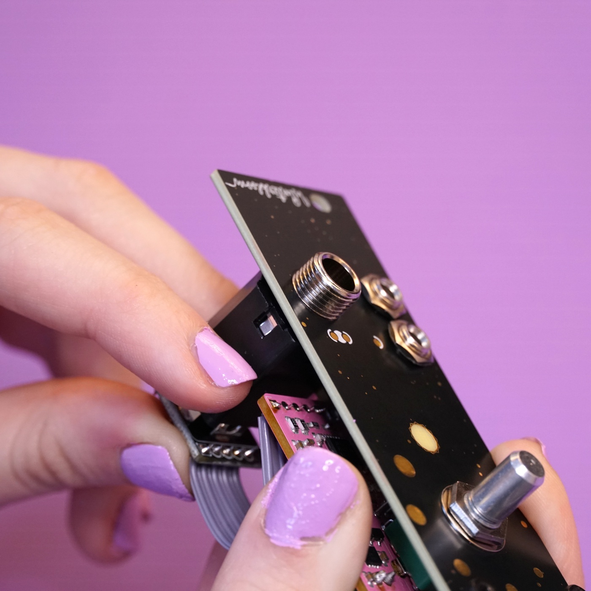
[picture p44: user_guide/docs/images/40-align-big-jack-2.jpg]
The large 1/4" jack being pushed through its hole in the front panel, with the flat flex cable bending to accommodate the new position.


Use the 1/4" jack's washer and nut to secure it to the panel.

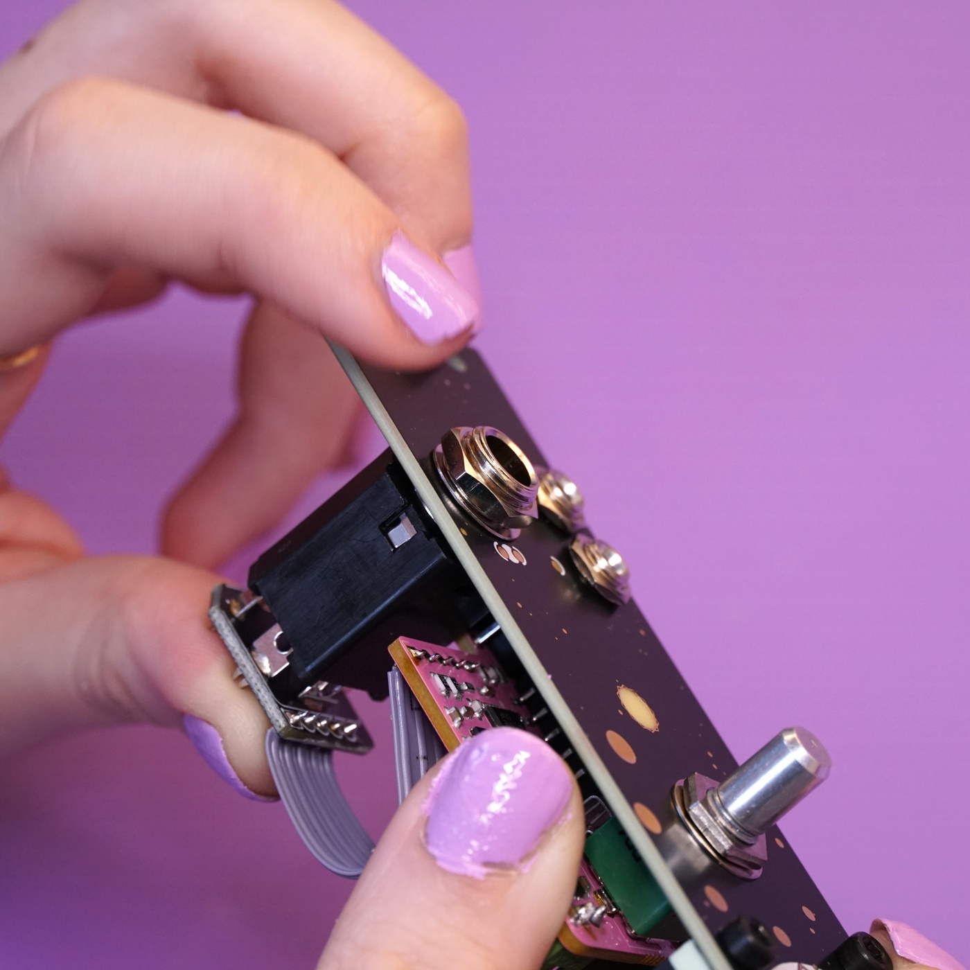
[picture p45: user_guide/docs/images/41-mount-big-jack-5.jpg]
The large 1/4" jack secured in place using its washer and nut


## Adding the volume knob

You're almost done! Next up is putting the volume knob on. You'll need the 2mm L wrench for this section.

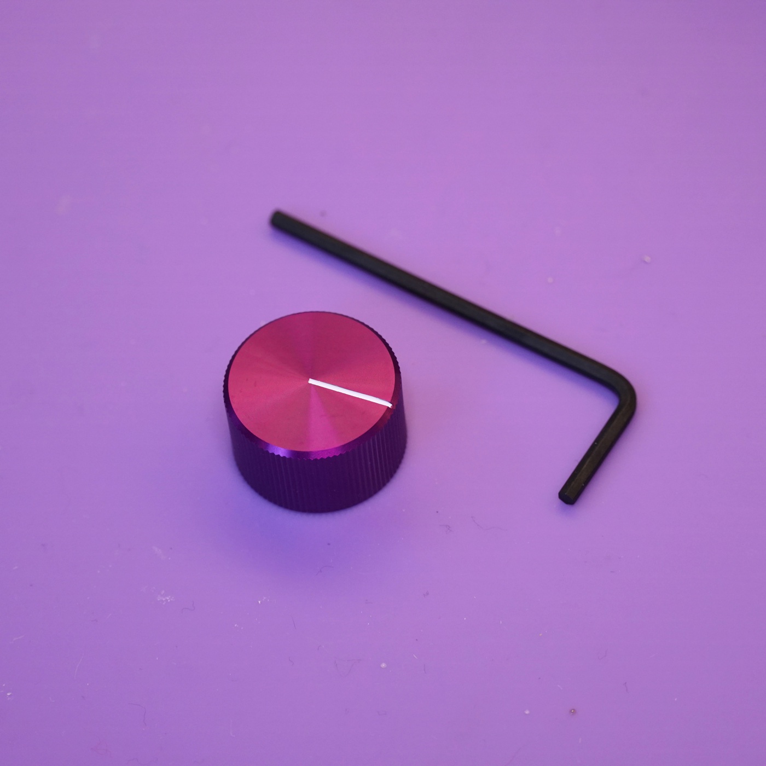
[picture p46: user_guide/docs/images/42-knob-4.jpg]
The 20mm aluminum volume know and a 2mm L wrench


Using the 2mm L wrench, loosen the grub screw inside the knob. Don't completely remove it, just loosen it enough so that it's not obstructing the hole in the center.

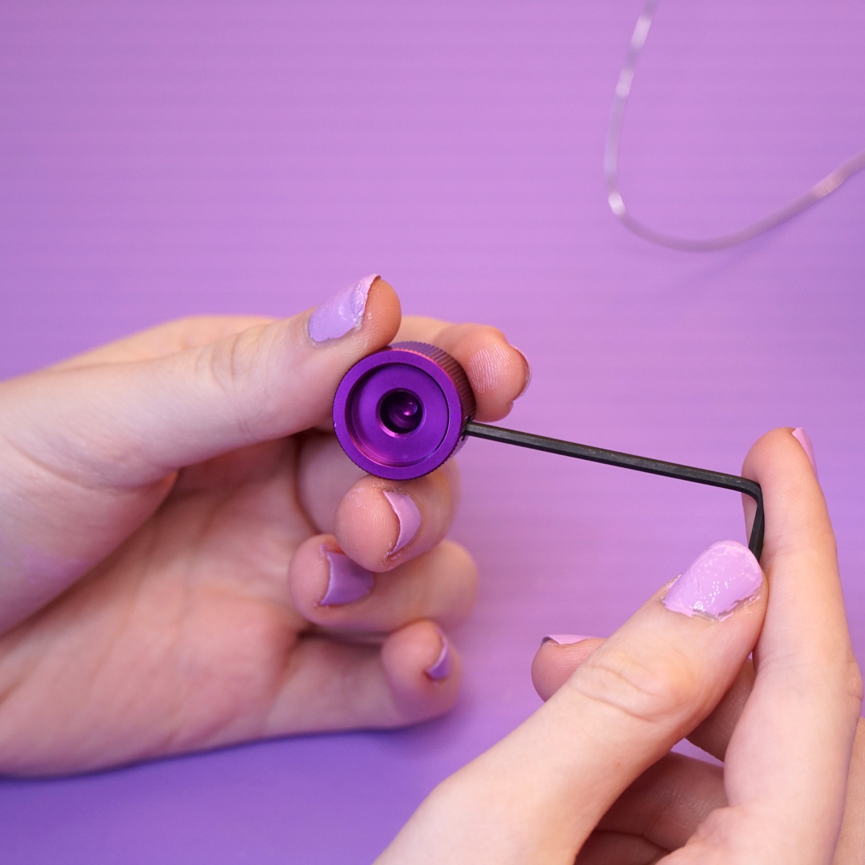
[picture p47: user_guide/docs/images/43-knob-loosen-2.jpg]
The 2mm L wrench being used to loosen the grub nut inside the knob


Before placing the knob, turn the potentiometer manually all the way counter-clockwise. Place the knob over the potentiometer's shaft with the white stripe pointing to about 7 o' clock.

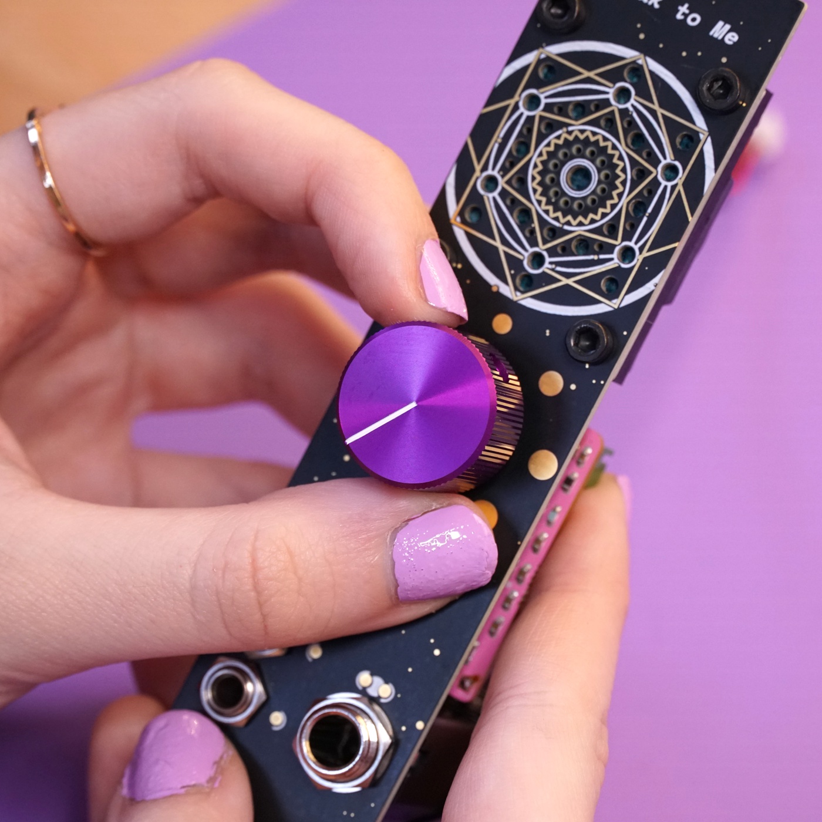
[picture p48: user_guide/docs/images/44-knob-placement-2.jpg]
The knob placed on the front panel, with its white stripe pointing to 7 o' clock


Use the 2.5mm L wrench to tighten the grub screw and secure the knob to the potentiometer's shaft.

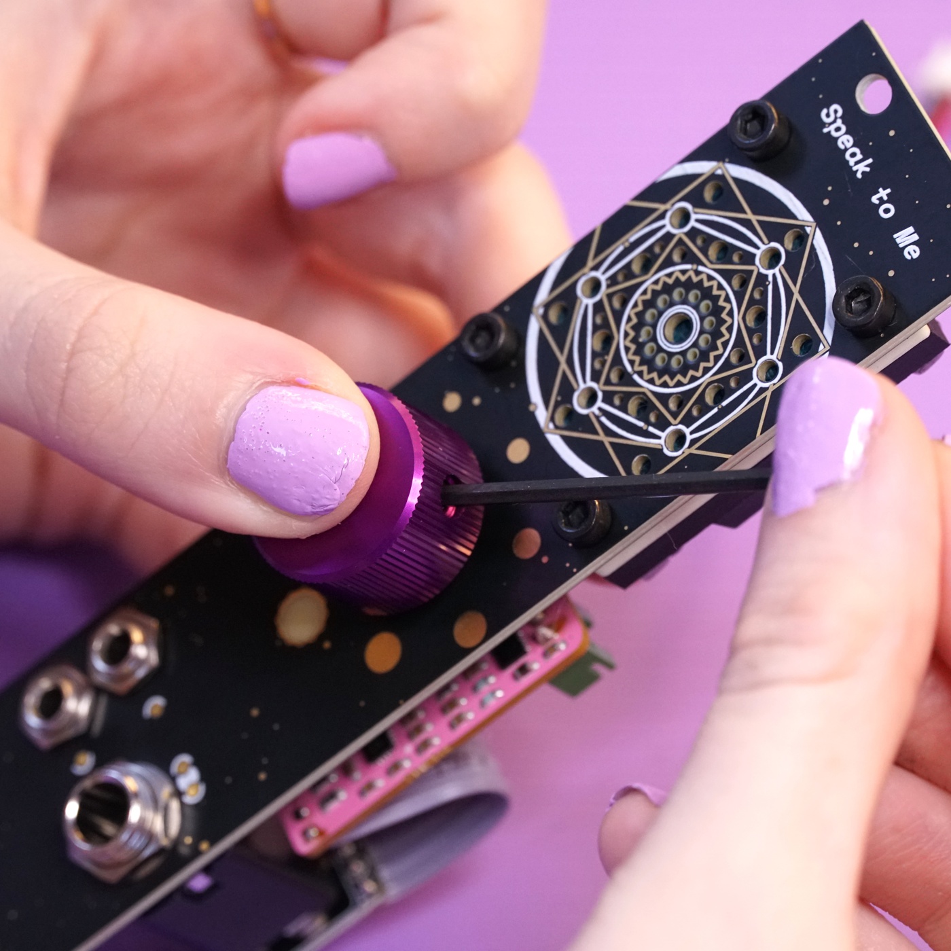
[picture p49: user_guide/docs/images/45-tighten-knob-5.jpg]
The 2.5mm L wrench being used to tighten the grub screw againt the potentiometer


## Plugging in the speaker

The last step is to plug in the speaker. Flip the module over and grab the speaker's JST cable.

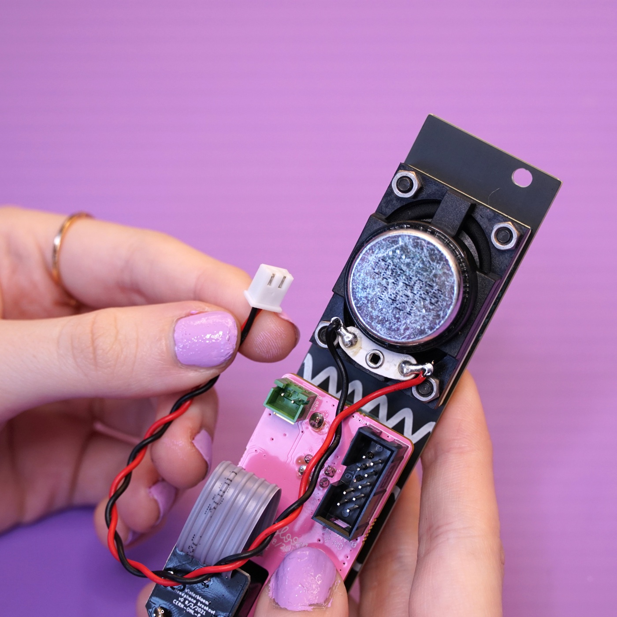
[picture p50: user_guide/docs/images/46-speaker-connection-2.jpg]
The back side of the module, showing the speaker's JST cable


Push the end of the JST cable into the JST header on the mainboard. It might take a little bit of force to get the cable to snap into place.

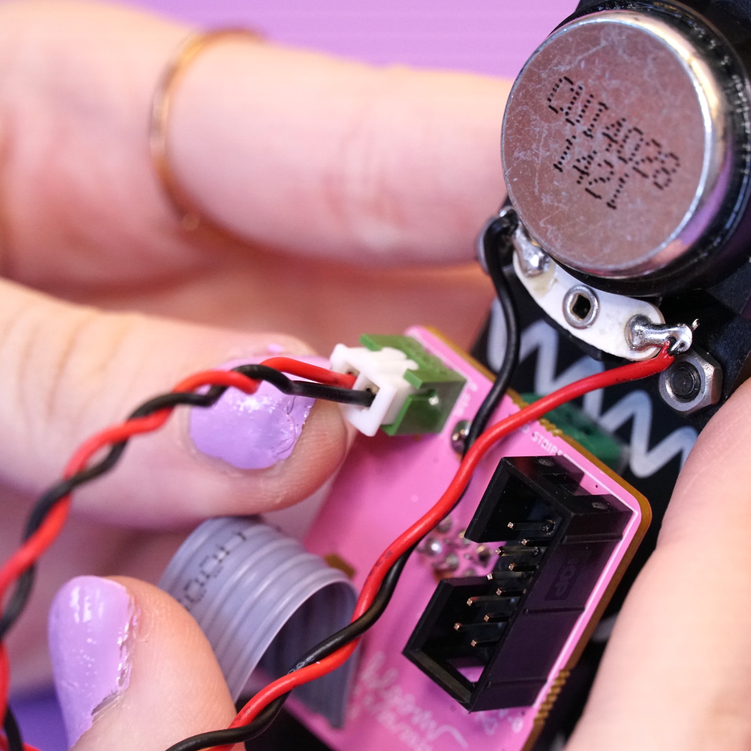
[picture p51: user_guide/docs/images/47-speaker-connected-4.jpg]
The JST cable plugged into the JST header on the mainboard


## All done

Congratulations! You've finished your very own Speak to Me!

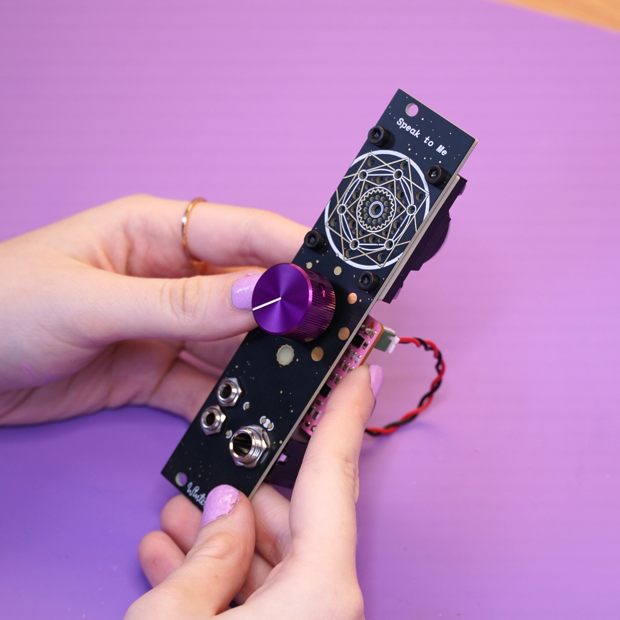
[picture p52: user_guide/docs/images/48-done-4.jpg]
The compeleted module


Now that it's all put together go check out the [User's Guide]() and please show us your work by tweeting at [@wntrblm](https://twitter.com/wntrblm) or tagging [@wntrblm](https://instagram.com/wntrblm) in your instagram post.
