wntrblm/Speak_to_Me/user_guide/docs/images/1-kit-15.jpg

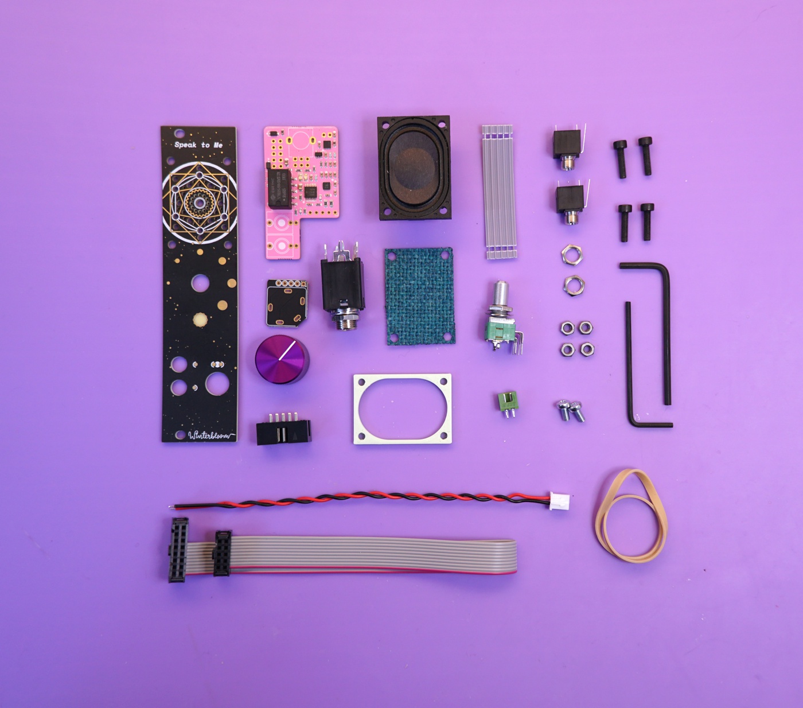
user_guide/docs/images/1-kit-15.jpg
