wntrblm/Speak_to_Me/user_guide/docs/images/3-pw-2.jpg

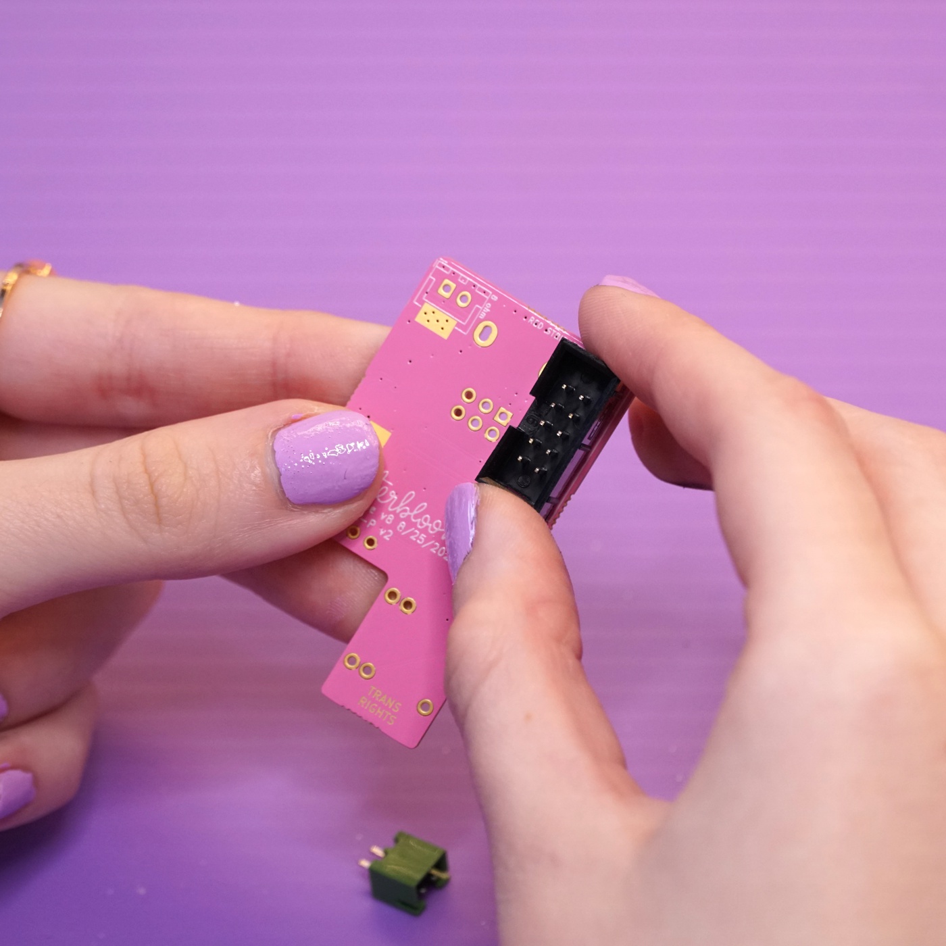
user_guide/docs/images/3-pw-2.jpg
