wntrblm/Speak_to_Me/user_guide/docs/images/18-solder-ffc-9.jpg

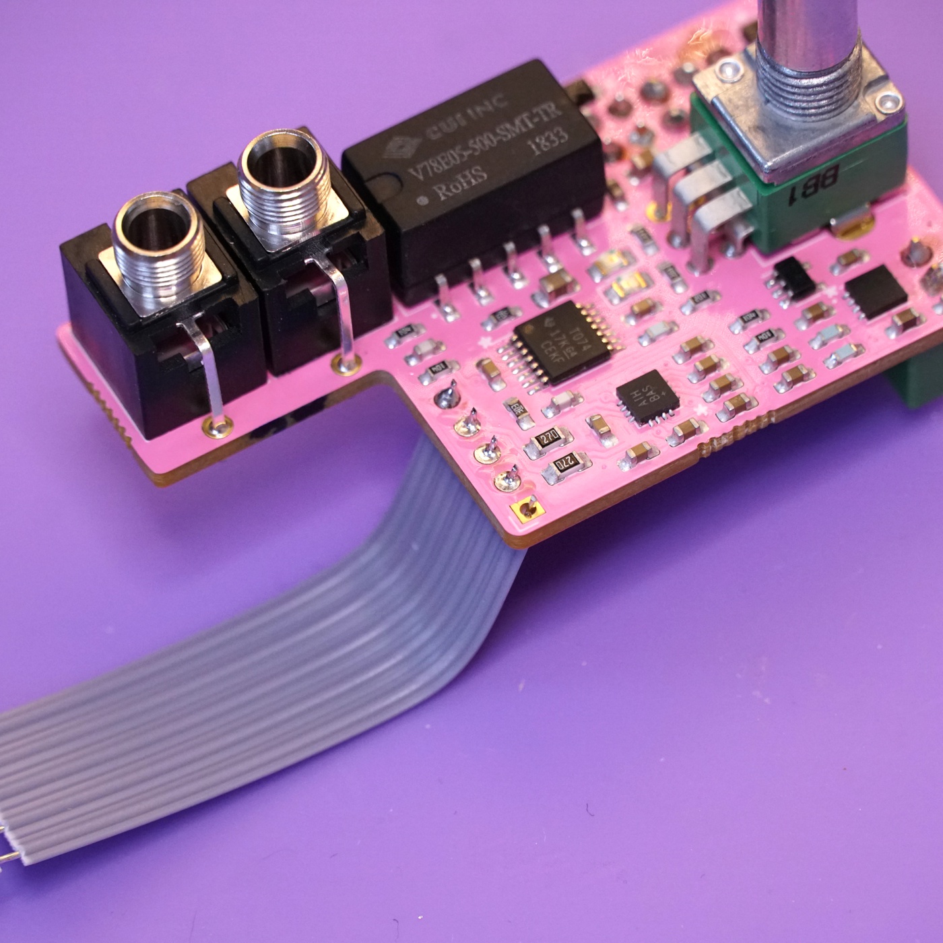
user_guide/docs/images/18-solder-ffc-9.jpg
