wntrblm/Speak_to_Me/user_guide/docs/images/26-speaker-3.jpg

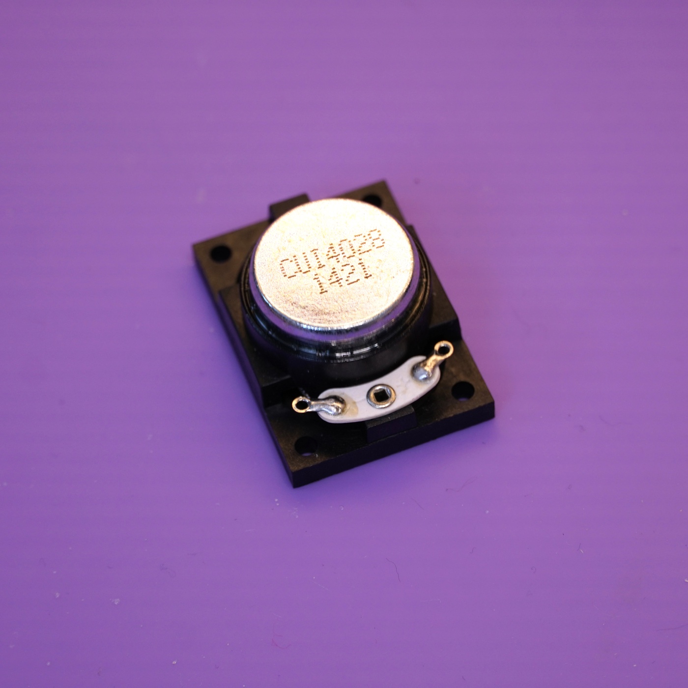
user_guide/docs/images/26-speaker-3.jpg
