wntrblm/Speak_to_Me/user_guide/docs/images/39-mount-jacks-1.jpg

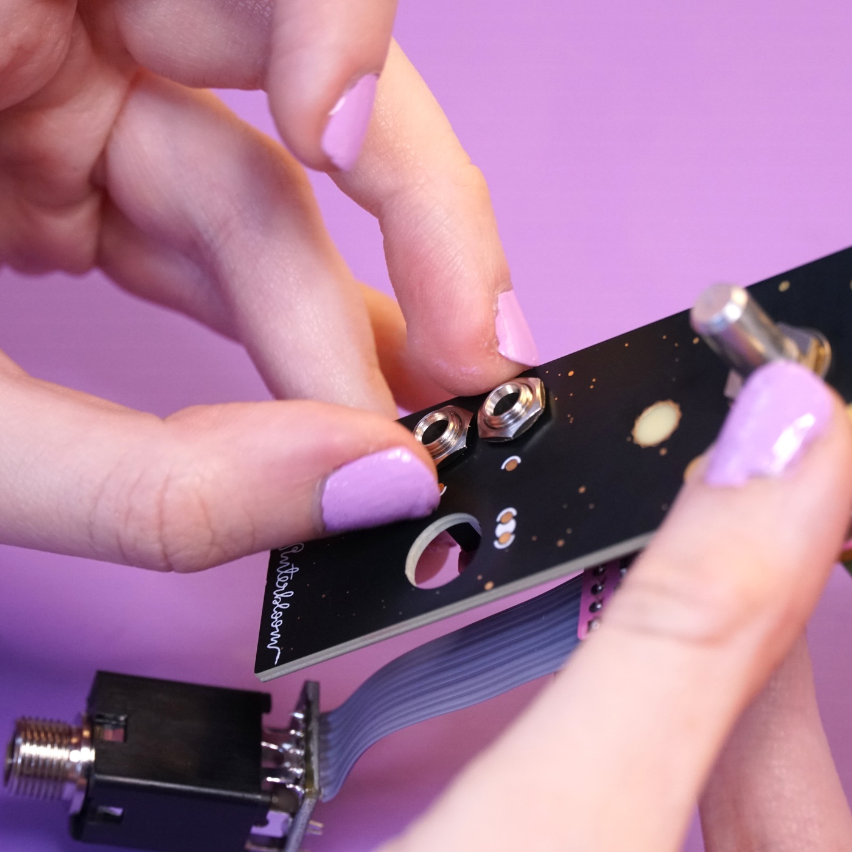
user_guide/docs/images/39-mount-jacks-1.jpg
