wntrblm/Speak_to_Me/hardware/board/board.pdf

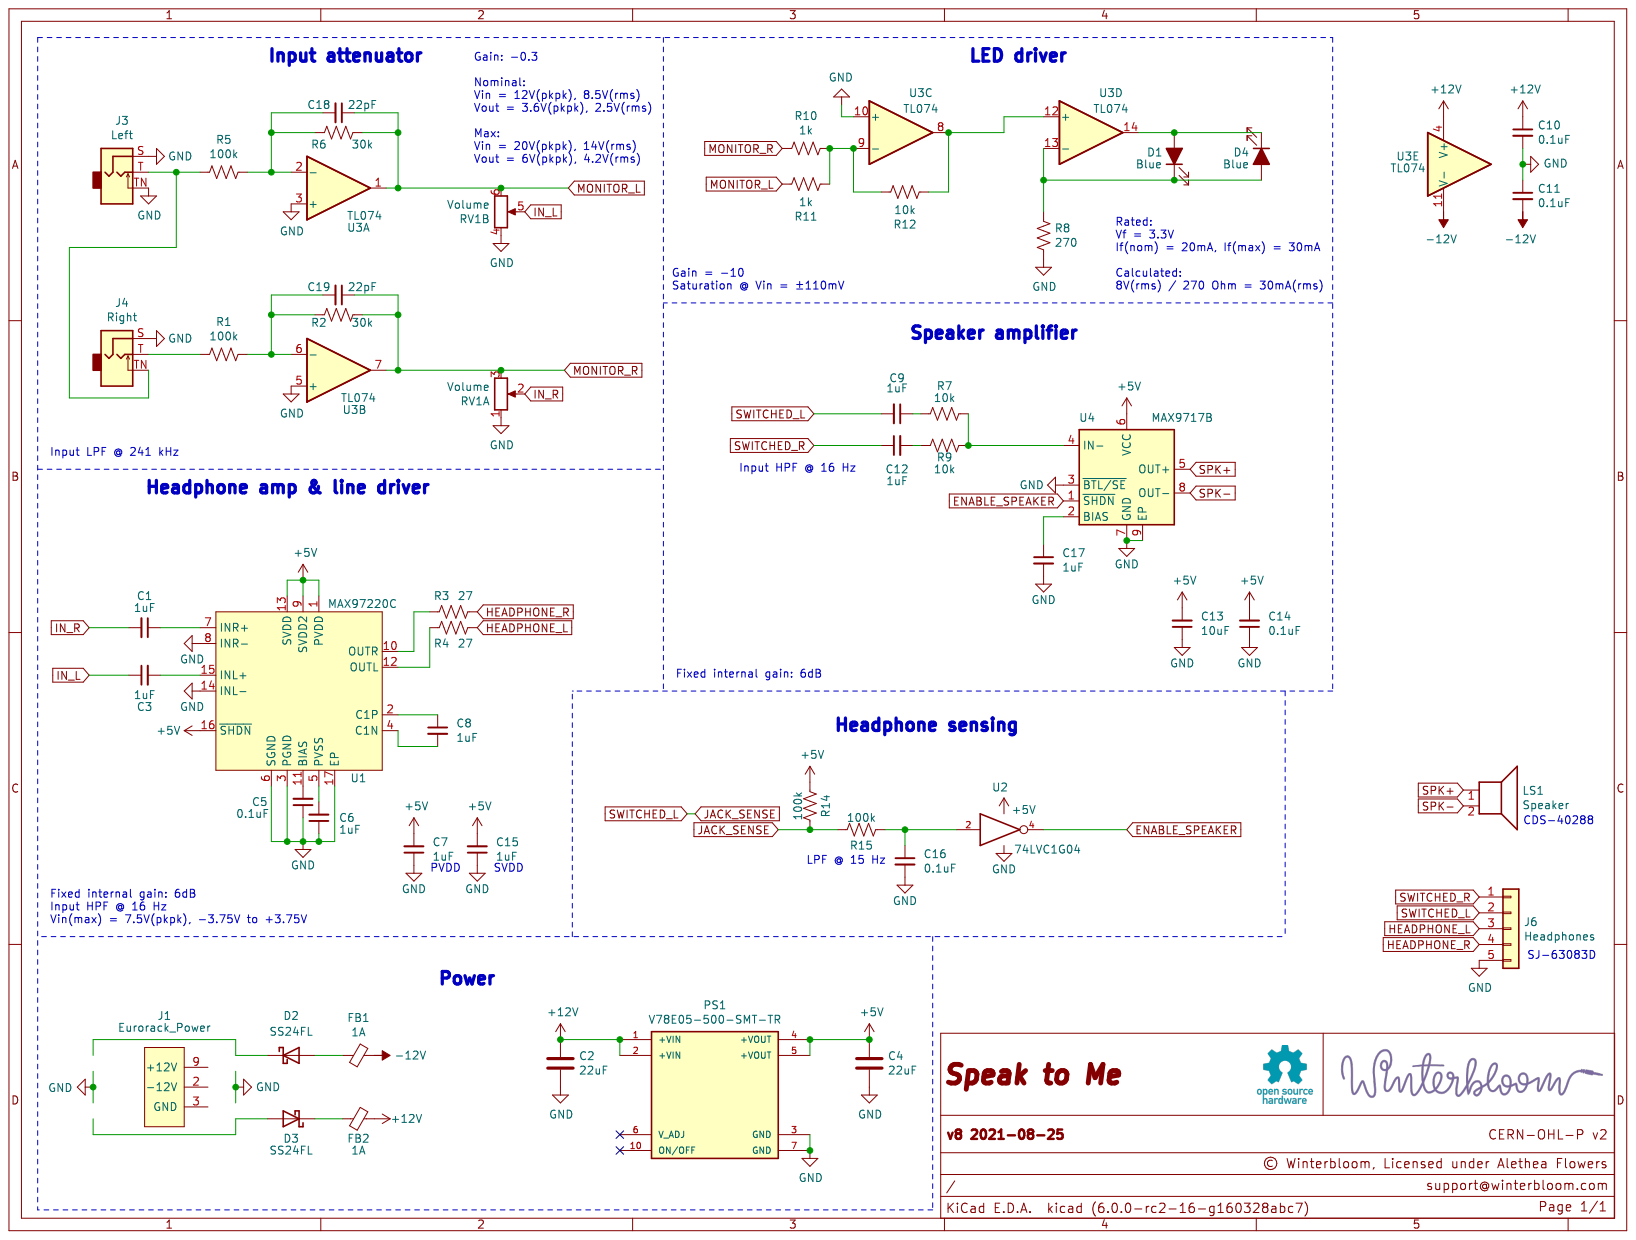
[picture p59: page 1]
