wntrblm/Speak_to_Me/(commit log)

2021-05-26 Move to different audio amp
    [board.kicad_pcb]
2021-07-07 Design new panel, switch to affinity2kicad
2021-07-08 hardware: Add proper MPNs
    [board.kicad_pcb, board.sch]
2021-07-29 Hardware v7
    - Fix headphone sense connection.
    - Remove unneeded pull-down resistors on speaker amp input.
    - Change input attenuator gain from 0.1 to 0.3.
    - Fix connection of thermal vias on headphone amplifier.
    [board.kicad_pcb, board.sch]
2021-08-03 Add headphone breakout
    [CUI_DEVICES_SJ-63083D.step, board.kicad_pcb, headphone-breakout.kicad_pcb, headphone-breakout.sch]
2021-08-04 Fix LED driver
    [board.kicad_pcb, board.sch]
2021-08-05 generated gerbes for headphone breakout; kicad did something
    [headphone-breakout.kicad_pcb]
2021-08-19 Small adjustments
    [board.kicad_pcb, board.sch]
2021-08-26 Hardware v8
    - Add current-limiting resistors to the headphone outputs.
    - Add stability caps to the input attenuator.
    - Re-layout the board, again.
    - Lower LED driver's preamp gain
    [board.kicad_pcb, board.sch]
2021-08-26 Fill in some more NPNs, select values for stability caps
    [board.kicad_pcb, board.sch]
2021-09-05 Update BOM
    [board.sch]
2021-11-07 Add PDF of schematic
2021-11-25 Add Hubble lens board
    [hubble-lens.kicad_pcb, hubble-lens.sch]
2022-01-25 hardware: move to KiCAD v6
    [board.kicad_pcb, board.kicad_sch, board.sch]
2022-06-19 user guide: link to assembled and kit product pages
2023-01-03 user guide: change the line out sections so that it's more clear which sort of cable needs to be used
2023-07-24 user guide: remove screws and power cable from kit contents
2024-02-23 user guide: switch to new Wintersong theme
2024-07-22 hardware: schematic and board revision 9
    - Brings page layout and overall style in line with newer Winterbloom projects
    - Revised LED driver schematic
    - Switched to 4-layer board
    - Re-done layout with our newer standards
    [3020-10-0300-00 3D.STEP, CUI_V78E05-500-SMT-TR.step, RK09L12-L15V.STEP, User Library-PJ301M-12 Thonkiconn v0_2.STEP, V78E05-500-SMT-TR.step, board.kicad_pcb, board.kicad_sch, c-5787834-1-c-3d.step]
2024-07-25 hardware: update plot parameters
    [board.kicad_pcb]
2025-01-30 hardware: Added faceplate
    [faceplate.kicad_pcb]
