wntrblm/Speak_to_Me/(notices)

Notices in the files:
hardware/faceplate/faceplate.kicad_pcb:
CC BY-NC-ND 4.0
